georg22tech/CLInGER/Camera System/HRI/FD_images/amentum_visit_test/1.2/image_2025-03-18_11-54-18.jpg

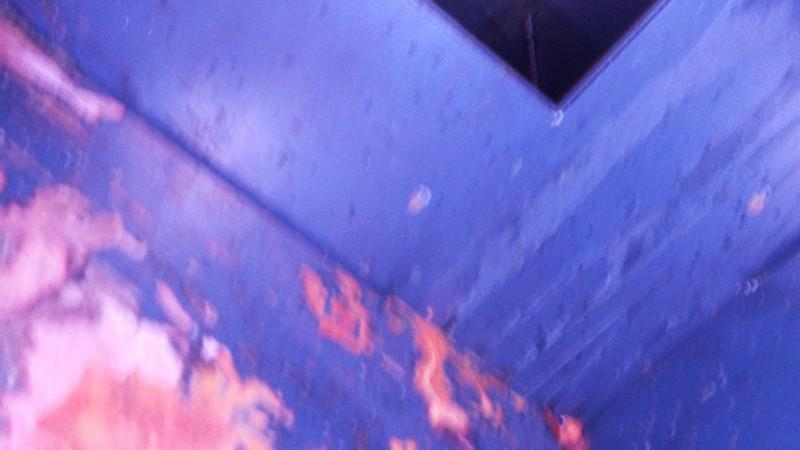
Camera System/HRI/FD_images/amentum_visit_test/1.2/image_2025-03-18_11-54-18.jpg
