georg22tech/CLInGER/README.md

# CLInGER
Repository of the Continuum Linear Inching Gantry Examination Robot (CLInGER)
