georg22tech/CLInGER/CAD_and_verification/Demo Day Schematics.pdf

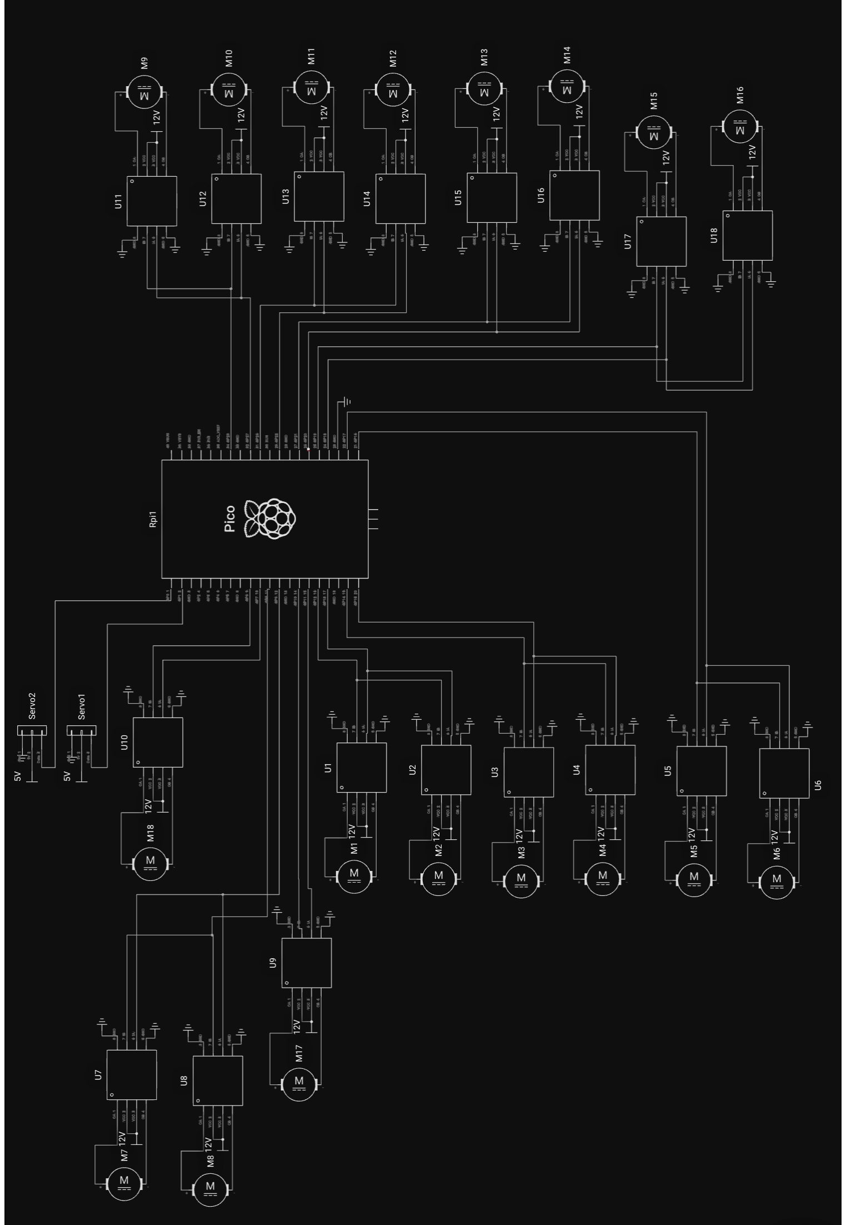
[picture p4: page 1]
