georg22tech/CLInGER/Appendices/Appendix A.15 - Control Methodology Diagrams/A.15.1 - continuum_ros2_interfaces.png

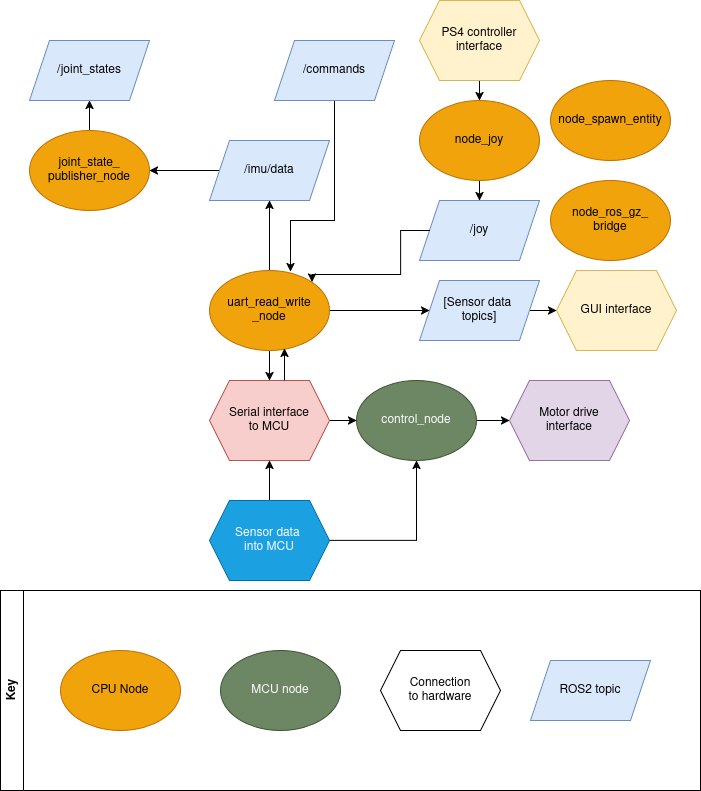
Appendices/Appendix A.15 - Control Methodology Diagrams/A.15.1 - continuum_ros2_interfaces.png
