georg22tech/CLInGER/Appendices/Appendix A.15 - Control Methodology Diagrams/A.15.2 - control_interactions_ros2.png

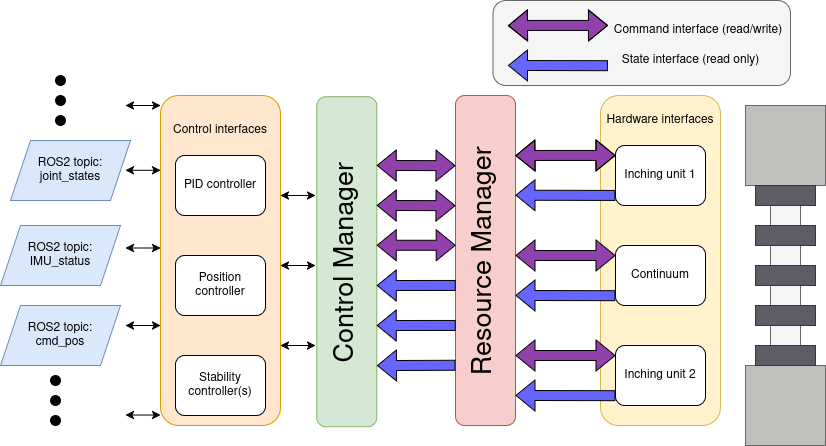
Appendices/Appendix A.15 - Control Methodology Diagrams/A.15.2 - control_interactions_ros2.png
