georg22tech/CLInGER/Appendices/Appendix A.15 - Control Methodology Diagrams/A.15.4 - continuum_control_flow.png

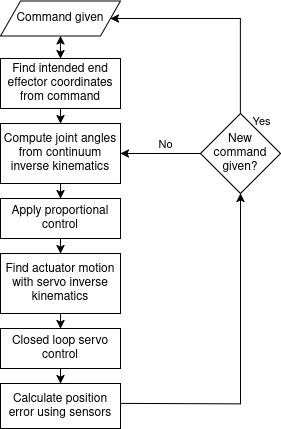
Appendices/Appendix A.15 - Control Methodology Diagrams/A.15.4 - continuum_control_flow.png
