georg22tech/CLInGER/Camera System/HRI/FD_images/image_2025-05-29_23-47-43.jpg

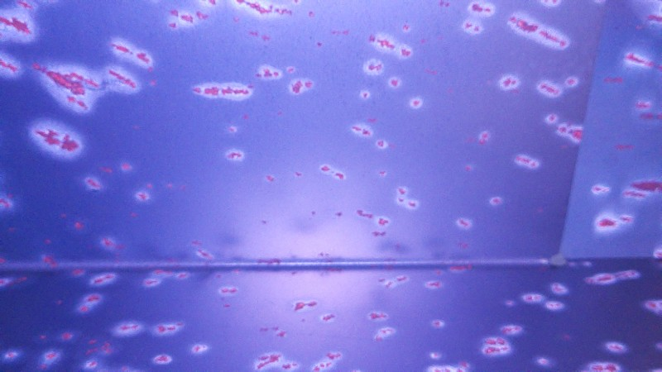
Camera System/HRI/FD_images/image_2025-05-29_23-47-43.jpg
