georg22tech/CLInGER/Camera System/HRI/FD_images/image_2025-05-30_00-00-45.jpg

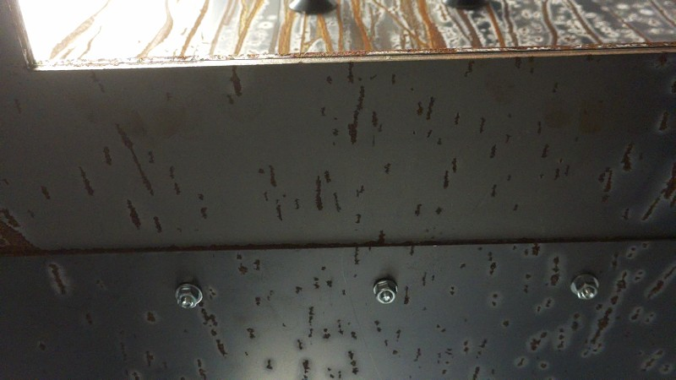
Camera System/HRI/FD_images/image_2025-05-30_00-00-45.jpg
