georg22tech/CLInGER/Camera System/HRI/FD_images/image_2025-05-30_00-04-07.jpg

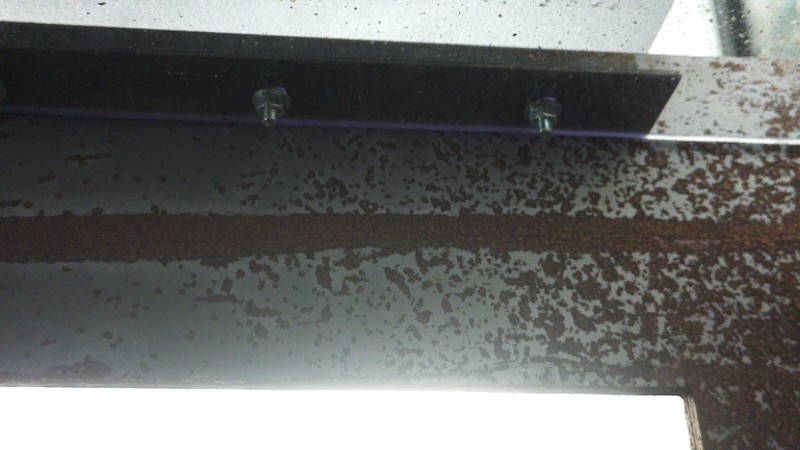
Camera System/HRI/FD_images/image_2025-05-30_00-04-07.jpg
