georg22tech/CLInGER/Camera System/HRI/yolo_v11_model/cracks_v4/train/confusion_matrix_normalized.png

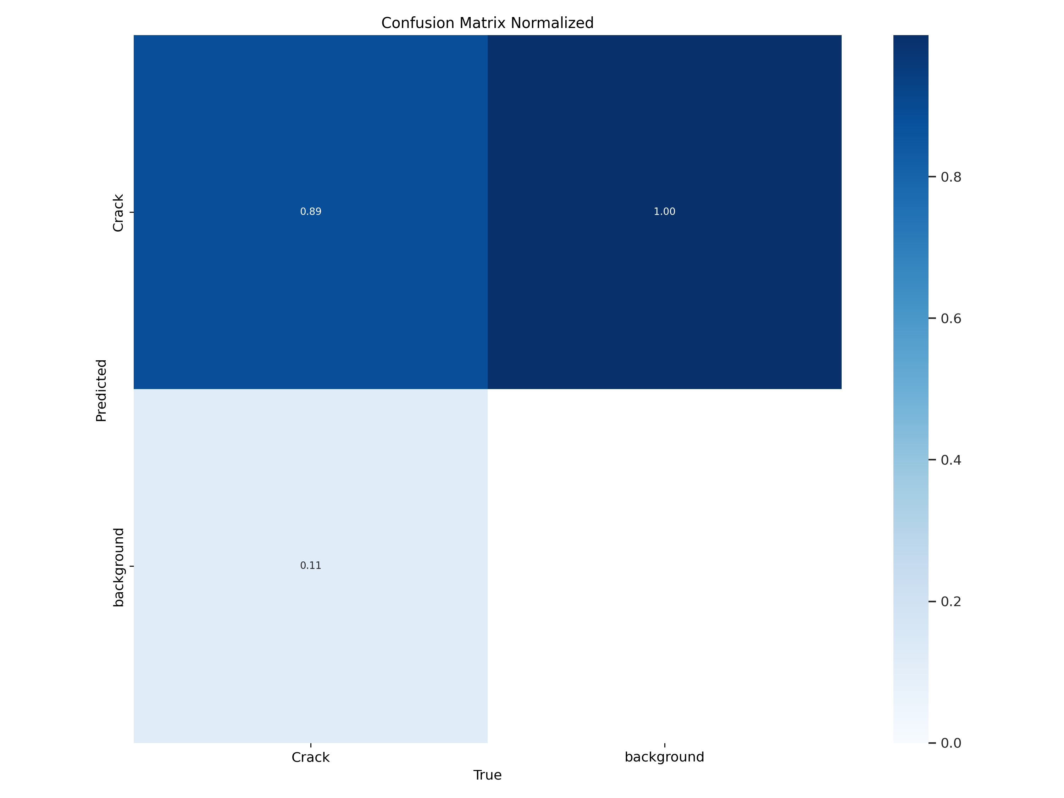
Camera System/HRI/yolo_v11_model/cracks_v4/train/confusion_matrix_normalized.png
