georg22tech/CLInGER/Camera System/HRI/yolo_v11_model/cracks_v4/train/labels_correlogram.jpg

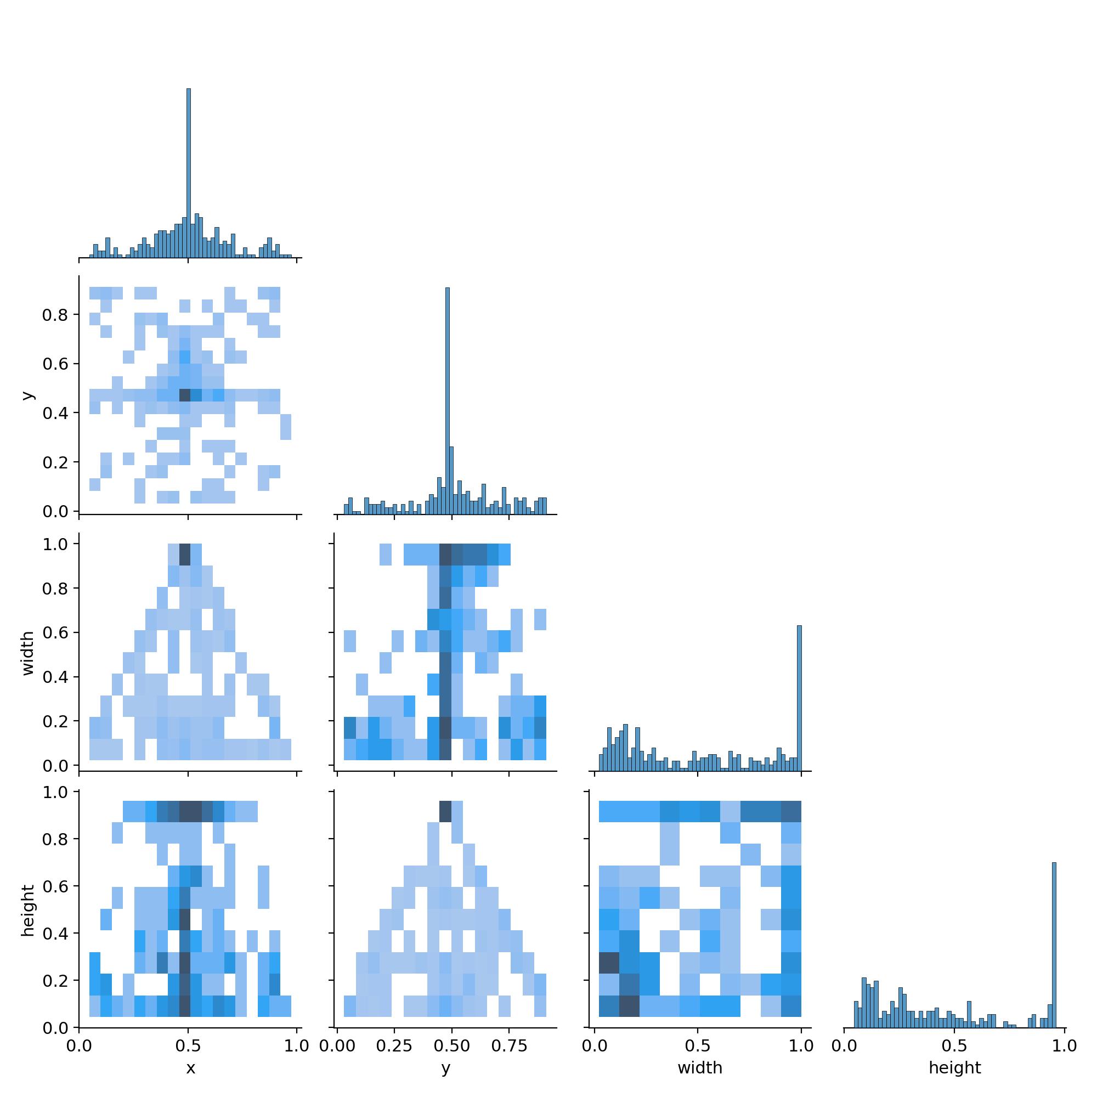
Camera System/HRI/yolo_v11_model/cracks_v4/train/labels_correlogram.jpg
