georg22tech/CLInGER/Camera System/HRI/yolo_v11_model/cracks_v4/train/R_curve.png

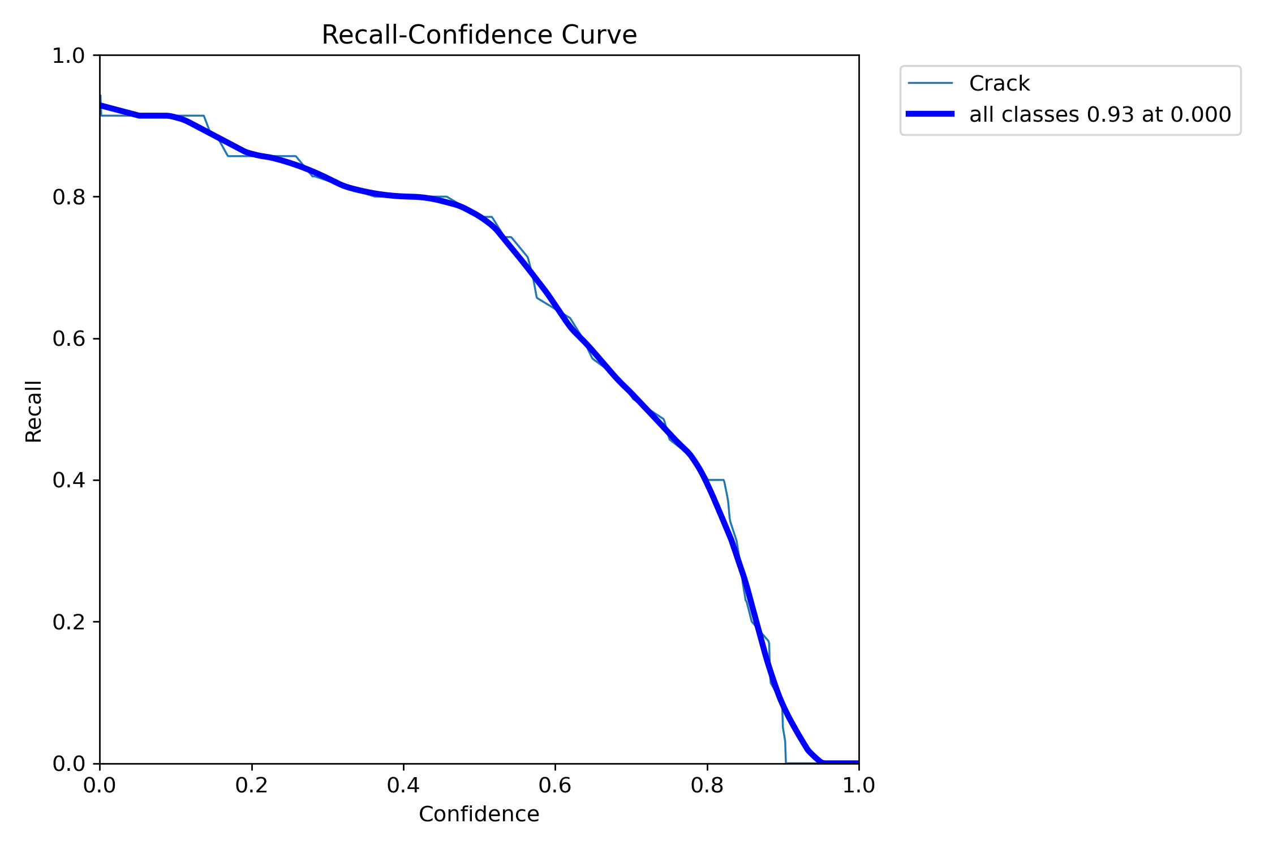
Camera System/HRI/yolo_v11_model/cracks_v4/train/R_curve.png
