georg22tech/CLInGER/Camera System/HRI/yolo_v11_model/cracks_v4/train/train_batch992.jpg

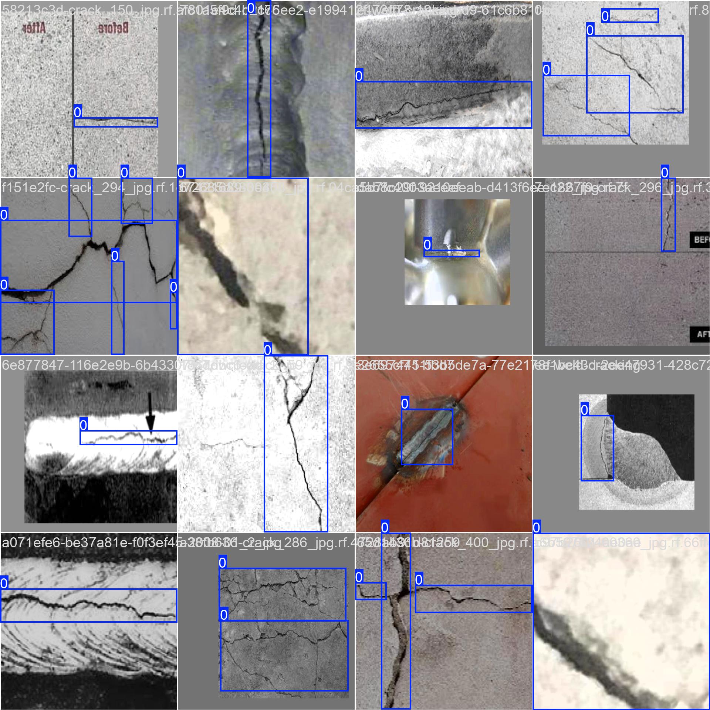
Camera System/HRI/yolo_v11_model/cracks_v4/train/train_batch992.jpg
