georg22tech/CLInGER/Camera System/HRI/yolo_v11_model/cracks_v4/train/val_batch0_labels.jpg

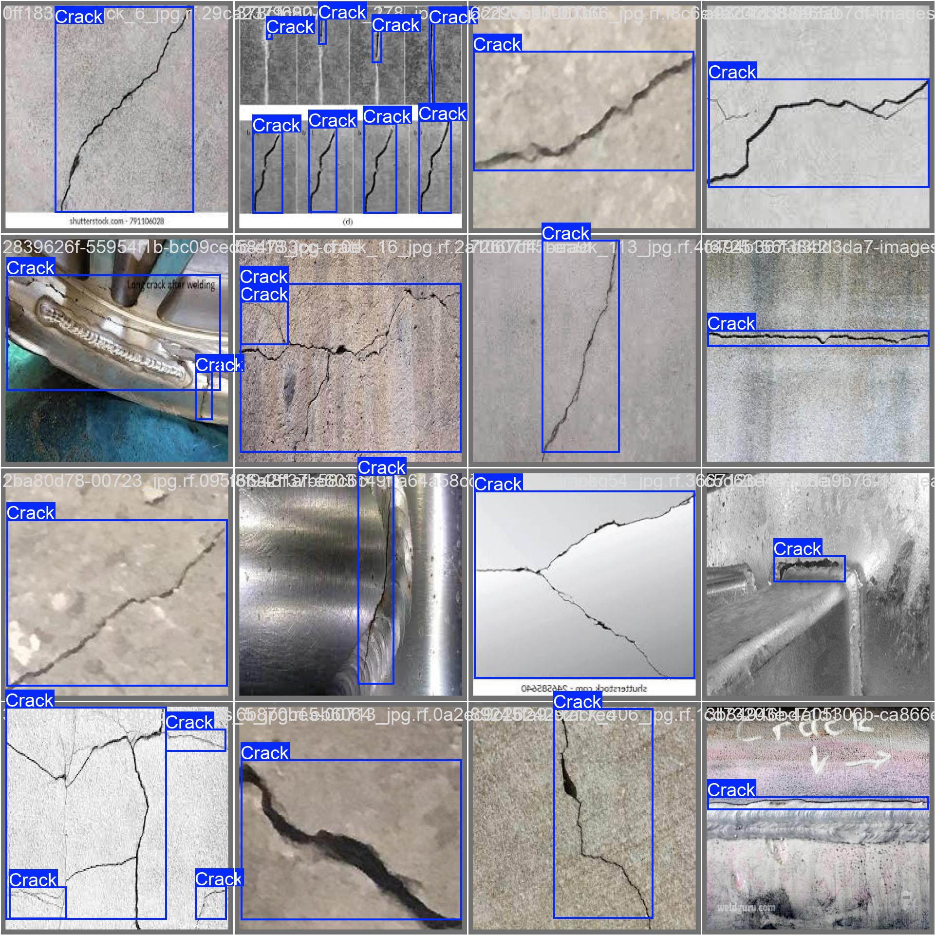
Camera System/HRI/yolo_v11_model/cracks_v4/train/val_batch0_labels.jpg
