georg22tech/CLInGER/Appendices/Appendix A.8 - Project Budget and Expenditure/Team 3 Inventory.xlsx

Sheet: Inventory Tracking
Number | Name | Category | Quantity | Location | Remarks
1 | Raspberry Pi 5 8GB | Control board | 1 | Main protoytpe
2 | Raspberry Pi Camera Module 3 | Sensor | 1 | Main protoytpe
3 | Raspberry Pi Pico | Control board | 4 | Main protoytpe | Preceding year item+ 3 bought this year, 2 on Main protoytpe
4 | RS Pro Timing Belt 6mm, 115.82mm | Inching mechanism | 1 | Room 2B.004
5 | Timing Belt Pulley 32 Tooth | Inching mechanism | 1 | Room 2B.004
6 | Timing Belt Pulley 12 Tooth | Inching mechanism | 1 | Room 2B.004
7 | Threaded Rod M10 1m | Inching mechanism | 1 | Room 2B.004
8 | M10 Hex Nut (50) | Inching mechanism | 1 | Room 2B.004
9 | Nylon 66 12mm width rods 1m | Turning mechanism | 1 | Room 2B.004 | Used for testing continuum backbone
10 | Nylon 66 5mm width rods 1m | Turning mechanism | 1 | Room 2B.004 | Used for testing continuum backbone
11 | Adafruit NeoPixel LED Ring | NDT payload | 1 | Main protoytpe
12 | TF Luna Lidar | Ranging sensor | 2 | Room 2B.004 | 1 used for demo prop
13 | Threadless Aluminium Alloy Busher | Turning mechanism | 100 | Room 2B.004 | 60 used for testing cycloid and continuum
14 | Micro Linear Actuator, 150 mm, 150 N | Holding mechanism | 17 | Main protoytpe | 16 on Main protoytpe
15 | Micro HDMI Cable, 5m | NDT payload | 1 | Room 2B.004
16 | Raspberry Pi 27W USB-C Power Supply | Pi 5 power supply | 1 | Room 2B.004
17 | RPi 5 Camera Adapter Cable, 500mm | NDT payload | 1 | Main protoytpe
18 | M6 Threaded Inserts, 9mm, pack of 20 | Inching mechanism | 1 | Room 2B.004
19 | M6 Threaded Rod, 1m | Inching mechanism | 3 | Room 2B.004
20 | GT2 9mm Timing Belt, 2.5m | Inching mechanism | 1 | Room 2B.004
21 | Grub Screws, M4x8mm, pack of 10 | Inching mechanism | 1 | Room 2B.004
22 | M6 Nut, pack of 50 | Inching mechanism | 1 | Room 2B.004
23 | M6 Lock Nut, pack of 50 | Inching mechanism | 1 | Room 2B.004
24 | GT2 Timing Belt Pulley, 20 teeth, 9mm belt, 8mm bore | Inching mechanism | 1 | Room 2B.004
25 | Bevel Gear, 5mm bore, 10 teeth | Inching mechanism | 1 | Room 2B.004
26 | 3M UV Safety glasses , PC Lens | Risk mitigating | 2 | Room 2B.004
27 | RS PRO M3 Brass Threaded Inserts, 4mm depth, 4.78mm (Pack of 100) | Turning mechanism | 1 | Room 2B.004
28 | Polycarbonate sheet 250x250x3mm | Inching mechanism | 5 | Room 2B.004 | Used for inching mechanism V1
29 | Polycarbonate sheet 100x500x3mm | Risk mitigating | 1 | Room 2B.004
30 | XL4015 DC-DC 5A Adjustable Step Down Power Supply Module | Power supply board | 5 | Main protoytpe
31 | L9110S H-Bridge Dual Channel Motor Driver | Actuator drive board | 12 | Main protoytpe | 6 on Main protoytpe
32 | 1.1A PTC Resettable Fuse 30V | Power supply safety | 8 | Room 2B.004
33 | 3-Way Single Row PCB Socket 2.54mm | PCB components | 16 | Main protoytpe
34 | 10-Way 3.81mm PCB Terminal 10A 150V | PCB components | 12 | Main protoytpe
35 | 40-Way Double Row PCB Socket 2.54mm | PCB components | 2 | Main protoytpe
36 | 20-Way Single Row PCB Socker 2.54mm | PCB components | 5 | Main protoytpe
37 | Spring Steel 2x40x1000x2 CS95 Carbon Steel | Turning mechanism | 2 | Main protoytpe | 1 piece on Main protoytpe
38 | RS PRO Bevel Gear, 5mm bore, 15 teeth, 1.0 module | Inching mechanism | 3 | Room 2B.004
39 | RS PRO Bevel Gear, 8mm bore, 30 teeth, 1.0 module | Inching mechanism | 1 | Room 2B.004
40 | Silicone Mold Making Kit 20A, Translucent, 38oz | Actuator end effector | 1 | Room 2B.004
41 | BNO055 9DOF Magnetic Field Module | Sensor | 3 | Main protoytpe | 2 on Main protoytpe
42 | VL53L1X Flight Time Sensors Module | Sensor | 6 | Main protoytpe | 4 on Main protoytpe
43 | 100m Fishing Line, 0.5mm Monofilament Clear Nylon Fishing Line | Turning mechanism | 1 | Room 2B.004
44 | Shift Register 8-bit - 74HC595 | Actuator control | 6 | Main protoytpe | 4 on Main protoytpe
45 | Wire-to board Terminal Block, Screwless, 5mm, 2-way | PCB components | 10 | Main protoytpe
46 | TruPower CQ-122N Mini Automotive Fuseholder | PCB components | 10 | Main protoytpe | 5 on Main protoytpe
47 | CamdenBoss 2 way, 10A, Interlocking Terminal Block, 3.81mm pitch | PCB components | 7 | Main protoytpe
48 | Sealey Automotive Standard Blade Fuse 5A | Power supply safety | 50 | Room 2B.004
49 | Sealey MBF550 Automotive MINI Blade Fuse 5A | Power supply safety | 50 | Room 2B.004 | 5 used for Main protoytpe
50 | ACS712 Hall Board Current Sensor Module 5A | Sensors | 8 | Room 2B.004
51 | 50kg Load Cell | Sensors | 4 | Room 2B.004
52 | HX711 Weight Pressure Sensor | Sensors | 2 | Room 2B.004
53 | Polycarbonate Clear 250x250x2mm | Chassis | 8 | Room 2B.004
54 | SER0046 Micro Servo | NDT payload | 2 | Main protoytpe
55 | Bourns 3690 10kOhm Rotary Potentiometer | Sensors | 2 | Room 2B.004
56 | Carbon Fibre Solid Rod 5x500 | Chassis | 4 | Main protoytpe
57 | CD74HC4067M96 Multiplexer Switch IC | Sensors | 10 | Main protoytpe | 2 used for Main protoytpe
58 | Micro Linear Actuator 12VDC, A Type 100mm, 150N 4mm/s | Actuator | 2 | Room 2B.004
59 | Small Linear Actuator, 12V 75mm stroke, Load 70N | Actuator | 2 | Main protoytpe
60 | Miniature Ball Bearing, 6x17x6mm | Chassis | 10 | Main protoytpe
61 | 40 kg Digital Servo High Voltage High Torque Metal Gear 360 Continuous Rotation | Turning mechanism | 3 | Main protoytpe | 2 used for Main protoytpe
62 | Polycarbonate Clear 1200x600x2mm | Chassis | 1 | Main protoytpe | Machined for chassis

Sheet: Handover Inventory
Number | Name | Category | Quantity | Location | Remarks
1 | Keysight E36312A Triple Output Programmable DC Power Supply | Tools | 1 | Room 2B.004
2 | 6000 Counts True RMS Multimeter | Tools | 1 | Room 2B.004
3 | WE70 Soldering Iron + WE1010 Power Unit | Tools | 1 | Room 2B.004
5 | 34450A 5 and 1/2 Digit Multimeter | Tools | 1 | Room 2B.004
6 | 33210A Function Generator | Tools | 1 | Room 2B.004
7 | RS Allen Key 1.5mm | Tools | 1 | Room 2B.004
8 | RS Allen Key 2mm | Tools | 1 | Room 2B.004
9 | RS Allen Key 2.5mm | Tools | 1 | Room 2B.004
10 | RS Allen Key 3mm | Tools | 1 | Room 2B.004
11 | RS Allen Key 4mm | Tools | 1 | Room 2B.004
12 | RS Allen Key 5mm | Tools | 1 | Room 2B.004
13 | RS Allen Key 6mm | Tools | 1 | Room 2B.004
14 | RS Allen Key 8mm | Tools | 1 | Room 2B.004
15 | RS Allen Key 10mm | Tools | 1 | Room 2B.004
16 | RS PRO Ignition Wrench 4mm | Tools | 1 | Room 2B.004
17 | RS PRO Ignition Wrench 4.5mm | Tools | 1 | Room 2B.004
18 | RS PRO Ignition Wrench 5mm | Tools | 1 | Room 2B.004
19 | RS PRO Ignition Wrench 5.5mm | Tools | 1 | Room 2B.004
20 | RS PRO Ignition Wrench 6mm | Tools | 1 | Room 2B.004
21 | RS PRO Ignition Wrench 7mm | Tools | 1 | Room 2B.004
22 | RS PRO Ignition Wrench 8mm | Tools | 1 | Room 2B.004
23 | RS PRO Ignition Wrench 9mm | Tools | 1 | Room 2B.004
24 | RS PRO Ignition Wrench 10mm | Tools | 1 | Room 2B.004
25 | RS PRO Ignition Wrench 11mm | Tools | 1 | Room 2B.004
26 | RS PRO Flathead Screwdriver 2x50 | Tools | 1 | Room 2B.004
27 | RS PRO Flathead Screwdriver 2.4x50 | Tools | 1 | Room 2B.004
28 | RS PRO Flathead Screwdriver 3x50 | Tools | 1 | Room 2B.004
29 | RS PRO Phillips Head Screwdriver 00x50 | Tools | 1 | Room 2B.004
30 | RS PRO Phillips Head Screwdriver 0x50 | Tools | 1 | Room 2B.004
31 | RS PRO Phillips Head Screwdriver 1x50 | Tools | 1 | Room 2B.004
32 | 606-490 Wire Cutter | Tools | 1 | Room 2B.004
33 | Tape Measure | Tools | 1 | Room 2B.004
34 | RS PRO Stanley Knife | Tools | 1 | Room 2B.004
35 | 0.5m Ethernet Cable | Others | 1 | Room 2B.004
36 | 0.5m HDMI to HMDI mini Cable | Others | 1 | Room 2B.004
37 | Raspberry Pi Camera 3 Wide Angle | Sensors | 1 | Room 2B.004
38 | Raspberry Pi Camera 2 8MP | Sensors | 2 | Room 2B.004
39 | Samsung 128GB Micro SD | Control | 1 | Room 2B.004 | Used on Pi 5
40 | TV6715DV 5.2V 2.5A USB-C Power Supply | Others | 1 | Room 2B.004
41 | USB-C Global Power Adapter 5.1V 15.3W | Others | 1 | Room 2B.004
42 | Bosch Sensortec Shuttle Board 3.0 BNO055 | Sensors | 1 | Room 2B.004
43 | VL53L5CX Breakout Boards | Sensors | 2 | Room 2B.004
44 | Raspberry Pi 5 8GB | Control board | 1 | Main protoytpe
45 | Raspberry Pi Camera Module 3 | Sensor | 1 | Main protoytpe
46 | Raspberry Pi Pico | Control board | 2 | Main protoytpe
47 | Threaded Rod M10 1m | Inching mechanism | 1 | Room 2B.004
48 | Adafruit NeoPixel LED Ring | NDT payload | 1 | Main protoytpe
49 | TF Luna Lidar | Ranging sensor | 2 | Room 2B.004 | 1 used for demo prop
50 | Micro Linear Actuator, 150 mm, 150 N | Holding mechanism | 17 | Main protoytpe | 16 on Main protoytpe
51 | Micro HDMI Cable, 5m | NDT payload | 1 | Room 2B.004
52 | Raspberry Pi 27W USB-C Power Supply | Pi 5 power supply | 1 | Room 2B.004
53 | RPi 5 Camera Adapter Cable, 500mm | NDT payload | 1 | Main protoytpe
54 | GT2 9mm Timing Belt, 2.5m | Inching mechanism | 1 | Room 2B.004
55 | Grub Screws, M4x8mm, pack of 10 | Inching mechanism | 1 | Room 2B.004
56 | Bevel Gear, 5mm bore, 10 teeth | Inching mechanism | 1 | Room 2B.004
57 | 3M UV Safety glasses , PC Lens | Risk mitigating | 2 | Room 2B.004
58 | L9110S H-Bridge Dual Channel Motor Driver | Actuator drive board | 12 | Main protoytpe | 6 on Main protoytpe
59 | 1.1A PTC Resettable Fuse 30V | Power supply safety | 8 | Room 2B.004
60 | Spring Steel 2x40x1000x2 CS95 Carbon Steel | Turning mechanism | 2 | Main protoytpe | 1 piece on Main protoytpe
61 | RS PRO Bevel Gear, 5mm bore, 15 teeth, 1.0 module | Inching mechanism | 3 | Room 2B.004
62 | RS PRO Bevel Gear, 8mm bore, 30 teeth, 1.0 module | Inching mechanism | 1 | Room 2B.004
63 | BNO055 9DOF Magnetic Field Module | Sensor | 3 | Main protoytpe | 2 on Main protoytpe
64 | VL53L1X Flight Time Sensors Module | Sensor | 6 | Main protoytpe | 4 on Main protoytpe
65 | 100m Fishing Line, 0.5mm Monofilament Clear Nylon Fishing Line | Turning mechanism | 1 | Room 2B.004
66 | Shift Register 8-bit - 74HC595 | Actuator control | 6 | Main protoytpe | 4 on Main protoytpe
67 | Sealey Automotive Standard Blade Fuse 5A | Power supply safety | 50 | Room 2B.004
68 | Sealey MBF550 Automotive MINI Blade Fuse 5A | Power supply safety | 50 | Room 2B.004 | 5 used for Main protoytpe
69 | ACS712 Hall Board Current Sensor Module 5A | Sensors | 8 | Room 2B.004
70 | SER0046 Micro Servo | NDT payload | 2 | Main protoytpe
71 | Bourns 3690 10kOhm Rotary Potentiometer | Sensors | 2 | Room 2B.004
72 | CD74HC4067M96 Multiplexer Switch IC | Sensors | 10 | Main protoytpe | 2 used for Main protoytpe
73 | Micro Linear Actuator 12VDC, A Type 100mm, 150N 4mm/s | Actuator | 2 | Room 2B.004
74 | Small Linear Actuator, 12V 75mm stroke, Load 70N | Actuator | 2 | Main protoytpe
75 | 40 kg Digital Servo High Voltage High Torque Metal Gear 360 Continuous Rotation | Turning mechanism | 2 | Main protoytpe | 2 used for Main protoytpe

Sheet: Main prototype
Item | Name | Quantity | Remarks
1 | Aluminium sheets | 8
2 | 3D printed spars | 44
3 | 3D printed feet | 16
4 | Carbon fibre rods 5mmx250mm | 8
5 | Custom PCB | 1 | Terminals and headers are not used because of motor drive board problem
6 | DC-DC buck converter | 5 | Soldered onto main PCB, 2 is broken but yet to debugged
7 | Motor drive board L9110S dual channel | 6
8 | Motor drive board L9110S four channel | 2
9 | Custom stripboard | 3 | Main stripboard containing Pico is not connected to power and yet to be debugged
10 | 3D printed ribs | 10
11 | 150N linear actuator 150mm extension | 16
12 | 150N linear actuator 75mm extension | 2
13 | 40kg digital servo continuous rotation | 2
14 | 24V/300W switching power supply | 1

Sheet: Demo Prop
Item | Name | Quantity | Remarks
1 | Custom 3D printed prop | 1
2 | Custom stripboard | 1
3 | ToF VL53l1X | 3
4 | TF Luna Lidar | 1
5 | BNO055 IMU Sensor | 2
6 | I2C Multiplexer TCA9548A | 1
7 | Trimmer Potentiometer 100kOhm | 1

Sheet: Camera prototype
Item | Name | Quantity | Remarks
 | 3D printed Camera mechanism | 1
 | Raspnberry Pi Camera Module 3 | 1
 | LED Ring | 1
 | 270 degrees DMS-MG90-A Micro Servo | 2
 | Custom stripboard | 1
 | Custom PCB | 1
 | Raspberry Pi Pico H | 1
