georg22tech/CLInGER/Appendices/Appendix A.8 - Project Budget and Expenditure/Order Forms/241108_MEng Team 3 Project Order Form 1.xlsx

Department of Electrical & Electronic Engineering MEng Team Project - Order Request
Team number & name | MEng Team 3 | Authorising Supervisor's Signature |  |  |  |  |  | Please use publicly quoted prices below,
Auditor name | Muhammad Bin Suratman |  |  |  |  |  |  | but note that University pricing may be different
Team AA code | AA18001
Supervisor names | Dr Simon Watson, Dr Paul Wright
Order request date | 2024-11-08 |  |  |  |  |  |  | Please be sure to quote prices excluding VAT
Company | Item Description | URL from Supplier Website | Reason for purchase | Implications if the order is not placed | Quantity | Item cost | Total cost | Office use
Farnell | Raspberry Pi 5 8GB | https://uk.farnell.com/raspberry-pi/rpi5-8gb-single/raspberry-pi-5-model-b-8gb-2-4ghz/dp/4256000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 | Control board for robot | Necessary to control sensors and actuators | 1 | £61.07 | £61.07
Farnell | Raspberry Pi Camera Module 3 | https://uk.farnell.com/raspberry-pi/sc0872/rpi-camera-mod-3-standard-lens/dp/4132318 | Sensor for robot | Robot cannot navigate | 1 | £19.23 | £19.23
RS | RS Pro Timing Belt 6mm, 115.82mm | https://uk.rs-online.com/web/p/timing-belts/7785039 | Testing load capability of motor | Motor cannot be tested | 1 | £1.62 | £1.62
RS | Timing Belt Pulley 32 Tooth | https://uk.rs-online.com/web/p/belt-pulleys/2362817?gb=s | Testing load capability of motor | Motor cannot be tested | 1 | £5.10 | £5.10
RS | Timing Belt Pulley 12 Tooth | https://uk.rs-online.com/web/p/belt-pulleys/2362767?gb=s | Testing load capability of motor | Motor cannot be tested | 1 | £3.40 | £3.40
Farnell | Threaded Rod M10 1m | https://uk.farnell.com/duratool/rod10/studding-steel-m10/dp/2444308 | Testing load capability of motor | Motor cannot be tested | 1 | £4.15 | £4.15
Farnell | M10 Hex Nut (pack of 50) | https://uk.farnell.com/tr-fastenings/m10-hfst-z50/full-nut-steel-bzp-m10-pk50/dp/1419453 | Testing load capability of motor | Motor cannot be tested | 1 | £5.66 | £5.66
 |  |  |  |  |  |  | £0.00
 |  |  |  |  |  |  | £0.00
 |  |  |  |  |  |  | £0.00
 |  |  |  |  |  |  | £0.00
 |  |  |  |  |  |  | £0.00
 |  |  |  |  |  |  | £0.00
 |  |  |  |  |  |  | £0.00
 |  |  |  |  |  |  | £0.00
 |  |  |  |  |  |  | £0.00
 |  |  |  |  |  |  | £0.00
 |  |  |  |  |  |  | £0.00
 |  |  |  |  |  |  | £0.00
 |  |  |  |  |  |  | £0.00
 |  |  |  |  |  |  | £0.00
 |  |  |  |  |  |  | £0.00
 |  |  |  |  |  |  | £0.00
 |  |  |  |  |  | ORDER TOTAL EXCL VAT | £100.23
Office use only |  |  |  |  |  | VAT | £20.05
Ordered by |  |  |  |  |  | ORDER TOTAL INCL VAT | £120.28
Order date
Requisition number
Note: All orders must be marked as follows, to ensure appropriate receipt of the items
4th year Project Team Number and Auditor’s Name, FAO - Daniel Vale, Room D8, Sackville Street Building – Delivery to Mr Peter Thomason, GRD stores, The Mill, Sackville St, University of Manchester, Manchester. M1 3BB.
