georg22tech/CLInGER/Appendices/Appendix A.8 - Project Budget and Expenditure/Order Forms/250131_MEng Team 3 Project Order Form 3.xlsx

Department of Electrical & Electronic Engineering MEng Team Project - Order Request
Team number & name | MEng Team 3 | Authorising Supervisor's Signature |  |  |  |  |  | Please use publicly quoted prices below,
Auditor name | Muhammad Bin Suratman |  |  |  |  |  |  | but note that University pricing may be different
Team AA code | AA18001
Supervisor names | Dr Simon Watson, Dr Paul Wright
Order request date | 2025-01-31 |  |  |  |  |  |  | Please be sure to quote prices excluding VAT
Company | Item Description | URL from Supplier Website | Reason for purchase | Implications if the order is not placed | Quantity | Item cost | Total cost | Office use
RS | Bevel Gear, 5mm Bore, 10 teeth | https://uk.rs-online.com/web/p/mitre-bevel-gears/1828012?gb=s | To build the necessary chassis for project | Chassis cannot be build | 1 | £5.31 | £5.31
 |  |  |  |  |  |  | £0.00
 |  |  |  |  |  |  | £0.00
 |  |  |  |  |  |  | £0.00
 |  |  |  |  |  |  | £0.00
 |  |  |  |  |  |  | £0.00
 |  |  |  |  |  |  | £0.00
 |  |  |  |  |  |  | £0.00
 |  |  |  |  |  |  | £0.00
 |  |  |  |  |  |  | £0.00
 |  |  |  |  |  |  | £0.00
 |  |  |  |  |  |  | £0.00
 |  |  |  |  |  |  | £0.00
 |  |  |  |  |  |  | £0.00
 |  |  |  |  |  |  | £0.00
 |  |  |  |  |  |  | £0.00
 |  |  |  |  |  |  | £0.00
 |  |  |  |  |  |  | £0.00
 |  |  |  |  |  |  | £0.00
 |  |  |  |  |  |  | £0.00
 |  |  |  |  |  |  | £0.00
 |  |  |  |  |  |  | £0.00
 |  |  |  |  |  |  | £0.00
 |  |  |  |  |  | ORDER TOTAL EXCL VAT | £5.31
Office use only |  |  |  |  |  | VAT | £1.06
Ordered by |  |  |  |  |  | ORDER TOTAL INCL VAT | £6.37
Order date
Requisition number
Note: All orders must be marked as follows, to ensure appropriate receipt of the items
4th year Project Team Number and Auditor’s Name, FAO - Daniel Vale, Room D8, Sackville Street Building – Delivery to Mr Peter Thomason, GRD stores, The Mill, Sackville St, University of Manchester, Manchester. M1 3BB.
