georg22tech/CLInGER/Appendices/Appendix A.8 - Project Budget and Expenditure/Order Forms/250211_MEng Team 3 Project Order Form 4.xlsx

Department of Electrical & Electronic Engineering MEng Team Project - Order Request
Team number & name | MEng Team 3 | Authorising Supervisor's Signature |  |  |  |  |  | Please use publicly quoted prices below,
Auditor name | Muhammad Bin Suratman |  |  |  |  |  |  | but note that University pricing may be different
Team AA code | AA18001
Supervisor names | Dr Simon Watson, Dr Paul Wright
Order request date | 2025-02-11 |  |  |  |  |  |  | Please be sure to quote prices excluding VAT
Company | Item Description | URL from Supplier Website | Reason for purchase | Implications if the order is not placed | Quantity | Item cost | Total cost | Office use
RS | 3M UV Safety Glasses, PC Lens | https://uk.rs-online.com/web/p/safety-glasses/1849475?gb=s | EN166 Safety requirements | Students may be at harm | 2 | £2.16 | £4.32
RS | Portwest Grey Polyurethane Cut Resistant Gloves, Size 9, 1 Pair | https://uk.rs-online.com/web/p/work-gloves/2372807?gb=s | EN388 Safety requirements | Students may be at harm | 2 | £4.00 | £8.00
RS | RS PRO M3 Brass Threaded Insert 4mm depth 4.78 mm (pack of 100) | https://uk.rs-online.com/web/p/threaded-inserts/0278584?gb=s | For building the robot | Robot might not work properly | 1 | £16.67 | £16.67
DirectPlastics | Polycarbonate clear 250x250x3mm | https://www.directplastics.co.uk/lexan-polycarb-sheet-250-x-250-x-3mm | For testing the robot chassis | Robot might not work properly | 3 | £3.30 | £9.90
DirectPlastics | Polycarbonate clear 1000x500x3mm | https://www.directplastics.co.uk/lexan-polycarb-sheet-1000-x-500-x-3mm | For testing spring steel | Students may be at harm | 1 | £21.78 | £21.78
 |  |  |  |  |  |  | £0.00
 |  |  |  |  |  |  | £0.00
 |  |  |  |  |  |  | £0.00
 |  |  |  |  |  |  | £0.00
 |  |  |  |  |  |  | £0.00
 |  |  |  |  |  |  | £0.00
 |  |  |  |  |  |  | £0.00
 |  |  |  |  |  |  | £0.00
 |  |  |  |  |  |  | £0.00
 |  |  |  |  |  |  | £0.00
 |  |  |  |  |  |  | £0.00
 |  |  |  |  |  |  | £0.00
 |  |  |  |  |  |  | £0.00
 |  |  |  |  |  |  | £0.00
 |  |  |  |  |  |  | £0.00
 |  |  |  |  |  |  | £0.00
 |  |  |  |  |  |  | £0.00
 |  |  |  |  |  |  | £0.00
 |  |  |  |  |  | ORDER TOTAL EXCL VAT | £60.67
Office use only |  |  |  |  |  | VAT | £12.13
Ordered by |  |  |  |  |  | ORDER TOTAL INCL VAT | £72.80
Order date
Requisition number
Note: All orders must be marked as follows, to ensure appropriate receipt of the items
4th year Project Team Number and Auditor’s Name, FAO - Daniel Vale, Room D8, Sackville Street Building – Delivery to Mr Peter Thomason, GRD stores, The Mill, Sackville St, University of Manchester, Manchester. M1 3BB.
