georg22tech/CLInGER/Appendices/Appendix A.8 - Project Budget and Expenditure/Order Forms/250221_MEng Team 3 Project Order Form 5.xlsx

Department of Electrical & Electronic Engineering MEng Team Project - Order Request
Team number & name | MEng Team 3 | Authorising Supervisor's Signature |  |  |  |  |  | Please use publicly quoted prices below,
Auditor name | Muhammad Bin Suratman |  |  |  |  |  |  | but note that University pricing may be different
Team AA code | AA18001
Supervisor names | Dr Simon Watson, Dr Paul Wright
Order request date | 2025-02-21 |  |  |  |  |  |  | Please be sure to quote prices excluding VAT
Company | Item Description | URL from Supplier Website | Reason for purchase | Implications if the order is not placed | Quantity | Item cost | Total cost | Office use
RS | RS PRO Bevel Gear, 5mm bore, 15 teeth, 1.0 module (pack of 3) | https://uk.rs-online.com/web/p/mitre-bevel-gears/1828002?gb=s | To build the necessary chassis for project | Chassis cannot be build | 1 | £6.36 | £6.36
RS | RS PRO Bevel Gear, 8mm bore, 30 teeth, 1.0 module | https://uk.rs-online.com/web/p/mitre-bevel-gears/1827994?gb=s | To build necessary chassis for project | Chassis cannot be build | 1 | £5.81 | £5.81
Rapid | Raspberry Pi 2MB SC0917 Pico H 32-bit | https://www.rapidonline.com/raspberry-pi-2mb-sc0917-pico-h-32-bit-soc-singles-75-1230 | Control board for the robot | Robot cannot be controlled | 1 | £4.04 | £4.04
Mouser | TF Luna Lidar | https://www.mouser.co.uk/ProductDetail/Benewake/TF-Luna-I2C?qs=DPoM0jnrROUWvdDwJYVpzw%3D%3D | Sensor for the robot | Data cannot be acquired | 1 | £16.42 | £16.42
 |  |  |  |  |  |  | £0.00
 |  |  |  |  |  |  | £0.00
 |  |  |  |  |  |  | £0.00
 |  |  |  |  |  |  | £0.00
 |  |  |  |  |  |  | £0.00
 |  |  |  |  |  |  | £0.00
 |  |  |  |  |  |  | £0.00
 |  |  |  |  |  |  | £0.00
 |  |  |  |  |  |  | £0.00
 |  |  |  |  |  |  | £0.00
 |  |  |  |  |  |  | £0.00
 |  |  |  |  |  |  | £0.00
 |  |  |  |  |  |  | £0.00
 |  |  |  |  |  |  | £0.00
 |  |  |  |  |  |  | £0.00
 |  |  |  |  |  |  | £0.00
 |  |  |  |  |  |  | £0.00
 |  |  |  |  |  |  | £0.00
 |  |  |  |  |  |  | £0.00
 |  |  |  |  |  | ORDER TOTAL EXCL VAT | £32.63
Office use only |  |  |  |  |  | VAT | £6.53
Ordered by |  |  |  |  |  | ORDER TOTAL INCL VAT | £39.16
Order date
Requisition number
Note: All orders must be marked as follows, to ensure appropriate receipt of the items
4th year Project Team Number and Auditor’s Name, FAO - Daniel Vale, Room D8, Sackville Street Building – Delivery to Mr Peter Thomason, GRD stores, The Mill, Sackville St, University of Manchester, Manchester. M1 3BB.
