georg22tech/CLInGER/Appendices/Appendix A.8 - Project Budget and Expenditure/Order Forms/250304_MEng Team 3 Project Order Form 6.xlsx

Department of Electrical & Electronic Engineering MEng Team Project - Order Request
Team number & name | MEng Team 3 | Authorising Supervisor's Signature |  |  |  |  |  | Please use publicly quoted prices below,
Auditor name | Muhammad Bin Suratman |  |  |  |  |  |  | but note that University pricing may be different
Team AA code | AA18001
Supervisor names | Dr Simon Watson, Dr Paul Wright
Order request date | 2025-03-04 |  |  |  |  |  |  | Please be sure to quote prices excluding VAT
Company | Item Description | URL from Supplier Website | Reason for purchase | Implications if the order is not placed | Quantity | Item cost | Total cost | Office use
Farnell | Wire-to board Terminal Block, Screwless, 5mm, 2 ways, 28 AWG(minimum 10) | https://uk.farnell.com/te-connectivity/2834076-1/tb-wire-to-board-2pos-28-14awg/dp/2610397 | Power distribution for project | Robot cannot be powered | 10 | £0.55 | £5.45
Rapid | TruPower CQ-122N Mini Automotive Fuseholder | https://www.rapidonline.com/trupower-cq-122n-mini-automotive-fuseholder-26-2470 | Fuse holder for power protection | Risk of fire if short circuit happen | 10 | £0.46 | £4.59
Rapid | CamdenBoss 2 way, 10A, Interlocking Terminal Block, 3.81mm pitch | https://www.rapidonline.com/camdenboss-ctb0308-2-2-way-10a-interlocking-terminal-block-3-81mm-pitch-21-1655 | Power distribution for project | Robot cannot be powered | 7 | £1.35 | £9.45
Rapid | Sealey Automotive Standard Blade Fuse 5A (pack of 50) | https://www.rapidonline.com/sealey-sbf550-automotive-standard-blade-fuse-5a-pack-of-50-84-0518 | Fuse for power protection | Risk of fire if short circuit happen | 1 | £1.99 | £1.99
 |  |  |  |  |  |  | £0.00
 |  |  |  |  |  |  | £0.00
 |  |  |  |  |  |  | £0.00
 |  |  |  |  |  |  | £0.00
 |  |  |  |  |  |  | £0.00
 |  |  |  |  |  |  | £0.00
 |  |  |  |  |  |  | £0.00
 |  |  |  |  |  |  | £0.00
 |  |  |  |  |  |  | £0.00
 |  |  |  |  |  |  | £0.00
 |  |  |  |  |  |  | £0.00
 |  |  |  |  |  |  | £0.00
 |  |  |  |  |  |  | £0.00
 |  |  |  |  |  |  | £0.00
 |  |  |  |  |  |  | £0.00
 |  |  |  |  |  |  | £0.00
 |  |  |  |  |  |  | £0.00
 |  |  |  |  |  |  | £0.00
 |  |  |  |  |  |  | £0.00
 |  |  |  |  |  | ORDER TOTAL EXCL VAT | £21.48
Office use only |  |  |  |  |  | VAT | £4.30
Ordered by |  |  |  |  |  | ORDER TOTAL INCL VAT | £25.78
Order date
Requisition number
Note: All orders must be marked as follows, to ensure appropriate receipt of the items
4th year Project Team Number and Auditor’s Name, FAO - Daniel Vale, Room D8, Sackville Street Building – Delivery to Mr Peter Thomason, GRD stores, The Mill, Sackville St, University of Manchester, Manchester. M1 3BB.
