georg22tech/CLInGER/Appendices/Appendix A.8 - Project Budget and Expenditure/Order Forms/250328_MEng Team 3 Project Order Form 10.xlsx

Department of Electrical & Electronic Engineering MEng Team Project - Order Request
Team number & name | MEng Team 3 | Authorising Supervisor's Signature |  |  |  |  |  | Please use publicly quoted prices below,
Auditor name | Muhammad Bin Suratman |  |  |  |  |  |  | but note that University pricing may be different
Team AA code | AA18001
Supervisor names | Dr Simon Watson, Dr Paul Wright
Order request date | 2025-03-28 |  |  |  |  |  |  | Please be sure to quote prices excluding VAT
Company | Item Description | URL from Supplier Website | Reason for purchase | Implications if the order is not placed | Quantity | Item cost | Total cost | Office use
Farnell | SER0046 Micro Servo | https://uk.farnell.com/dfrobot/ser0046/servo-motor-270deg-1-47n-m-6v/dp/3769942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 | Camera control | Camera cannot be controlled | 2 | £5.95 | £11.90
Farnell | Raspberry Pi Pico H | https://uk.farnell.com/raspberry-pi/raspberry-pi-pico-h/raspberry-pi-board-arm-cortex/dp/3996081 | Sensors and actuator control | Cannot read sensors and control actuators | 2 | £3.97 | £7.94
RS | Bourns 3690 10kOhm Rotary Potentiometer | https://uk.rs-online.com/web/p/potentiometers/1070785?gb=s | Encoder testing | Encoder cannot be tested | 2 | £13.44 | £26.88
Mouser | Adafruit 9-DoF Absolute Orientation IMU BNO055 | https://www.mouser.co.uk/ProductDetail/Adafruit/4646?qs=W%2FMpXkg%252BdQ4Msqspav40iw%3D%3D | To build robot | Robot cannot be built | 1 | £19.68 | £19.68
Mouser | Distance Sensor VL53L1X ToF Sensor Breakout | https://www.mouser.co.uk/ProductDetail/Pimoroni/PIM373?qs=lc2O%252BfHJPVbu7kI%2FlA0xSg%3D%3D | To build robot | Robot cannot be built | 2 | £12.55 | £25.10
 |  |  |  |  |  |  | £0.00
 |  |  |  |  |  |  | £0.00
 |  |  |  |  |  |  | £0.00
 |  |  |  |  |  |  | £0.00
 |  |  |  |  |  |  | £0.00
 |  |  |  |  |  |  | £0.00
 |  |  |  |  |  |  | £0.00
 |  |  |  |  |  |  | £0.00
 |  |  |  |  |  |  | £0.00
 |  |  |  |  |  |  | £0.00
 |  |  |  |  |  |  | £0.00
 |  |  |  |  |  |  | £0.00
 |  |  |  |  |  |  | £0.00
 |  |  |  |  |  |  | £0.00
 |  |  |  |  |  |  | £0.00
 |  |  |  |  |  |  | £0.00
 |  |  |  |  |  |  | £0.00
 |  |  |  |  |  |  | £0.00
 |  |  |  |  |  | ORDER TOTAL EXCL VAT | £91.50
Office use only |  |  |  |  |  | VAT | £18.30
Ordered by |  |  |  |  |  | ORDER TOTAL INCL VAT | £109.80
Order date
Requisition number
Note: All orders must be marked as follows, to ensure appropriate receipt of the items
4th year Project Team Number and Auditor’s Name, FAO - Daniel Vale, Room D8, Sackville Street Building – Delivery to Mr Peter Thomason, GRD stores, The Mill, Sackville St, University of Manchester, Manchester. M1 3BB.
