georg22tech/CLInGER/Appendices/Appendix A.2 - Risk Registers/Appendix - Mitigating Risks.xlsx

ID | Risk Description | Category | Likelihood | Impact | Risk Score | Mitigation Strategy | Owner | Notes on Decisions
1 | Camera fails to reach rear flange due to 180° servo design mechanical limits | Technical | 4 | 4 | 16 | Switched from 180° to 270° micro-servos; tested in lab mock-up to confirm coverage | Alen | Original 180° design dropped; new design proved complete coverage
2 | Glare/reflection from LED ring obscures crack detection | Technical | 3 | 4 | 12 | Set default LED brightness to 25%; allow runtime adjustment; consider diffuser in future | Alen | High brightness (>50%) caused glare; 25% balanced exposure.
3 | Autofocus on Pi Camera unreliable under movement, blurring images | Technical | 2 | 3 | 6 | Added manual focus slider so operator can adjust focus in real time | Alen | Disabled Pi Cam’s autofocus; manual focus gives consistent sharpness despite camera motion.
4 | Image‐capture failure or metadata loss | Technical | 1 | 3 | 3 | Implementing a error popup | Alen | Future work can include this feature, due to time constraint not available in final demonstration
5 | UART comms drop-outs between Pi 5 and Pico causing misalignment | Technical | 2 | 4 | 8 | Adding robust PCB headers, enruing that connection cannot be lost | Mur | Headers have been included
6 | Dataset bias or poor generalization of crack-detection model | Technical | 2 | 5 | 10 | Trained on diverse materials from Roboflow; plan to augment with on-site images before final deploy | Alen | Current dataset covers common cases; further fine-tuning needed for rare defect types.
7 | Latency in camera feed due to object deteciton overlay | Technical | 4 | 1 | 4 | Creating YOLO toggle on GUI disabling overlay to increase FPS; consider multi-threaded display loop | Alen | Toggling off YOLO overlay measurably increased feed FPS
8 | Continuum backbone permanent deformation due to material fatigue | Technical | 3 | 4 | 12 | Switched from nylon 66 to 2 mm spring steel sheet | Madeline | Initial nylon tests showed permanent set; spring steel backbone shows retention
9 | Anchor ribs 3D-printed material cracking at continuum-inching interface | Technical | 2 | 4 | 8 | Recommend future work to have CNC-machined metal ribs for production | George | Budget constraints dictated 3D-print; but metal will improve durability under repeated loads
10 | Ergonomic confusion in PS4-controller mapping | Usability | 2 | 3 | 6 | Adding a control map tab to the GUI so the operator can review commands throughout the inspection | Alen | Future work can include this feature, due to time constraint not available in final demonstration
11 | Sensor-fusion drift or misalignment in RViz visualization | Technical | 2 | 4 | 8 | Adopted direct sensor data publisher (no Kalman) given low robot speeds | Danny
12 | Continuum-inching cable fatigue and snagging | Operational | 2 | 3 | 6 | Routed cables along non-tendon side,used abrasion-resistant sleevin | Madeline
13 | Inching mechanism stalls under load due to belt/rod friction | Operational | 3 | 4 | 12 | Lubricate guide rods and timing belts; include stall-detection in firmware to retry or reverse if jammed | Mur | Lubrication will be added on demonstration day
14 | Sensor sampling jitter impacting localization accuracy | Sensing | 2 | 3 | 6 | Improve multi-threading code | Danny
15 | Raspberry Pi 5 CPU thermal throttling under sustained high load | Hardware | 2 | 4 | 8 | Add heatsink + small fan; monitor CPU temperature in firmware and throttle non-critical tasks; alert operator if throttling occurs | Alen | Currently whilst operating temperature do not exceed safety values, however, for future work this can be implemented so hardware does not overheat during oepration
16 |  |  |  |  | 0
17 |  |  |  |  | 0
18 |  |  |  |  | 0
19 |  |  |  |  | 0
20 |  |  |  |  | 0
