georg22tech/CLInGER/Appendices/Appendix A.8 - Project Budget and Expenditure/Team 3 Budget.xlsx

Sheet: Preferred Supplier List
Lot | Description | Appointed Suppliers | Contact Name | Email Address | Telephone Number
1 | Electronic Components Associated Products & Service Kits | 1. City Electrical Factors | Paul Nightingale | 32TUnato@cef.co.ukU32T | 01733 402816
 |  | 2. Farnell Onecall | Michael Reeks | 32Tmreeks@premierfarnell.com32T | 07920 419 500
 |  | 3. Rapid Electronics | Chris Calver | 32Tchris.calver@rapidonline.com32T | 01206 838020
 |  | 4. Rexel | Tom Norris | 32Ttom.Norris@rexel.co.uk32T | 07741 291484
 |  | 5. RS Components | Kudzai Manduvi | 32TKudzai.manduvi@rs-components.com32T | 07827 841519
2 | Tools & Fixings | 1. City Electrical Factors | Paul Nightingale | 32Tnato@cef.co.uk32T | 01733 402816
 |  | 2. Farnell Onecall | Michael Reeks | 32Tmreeks@premierfarnell.com32T | 07920 419 500
 |  | 3. Rapid Electronics | Chris Calver | 32Tchris.calver@rapidonline.com32T | 01206 838020
 |  | 4. Rexel | Tom Norris | 32Ttom.Norris@rexel.co.uk32T | 07741 291484
 |  | 5. RS Components | Kudzai Manduvi | 32TKudzai.manduvi@rs-components.com32T | 07827 841519
 |  | 6. Screwfix Direct | Zoe Harris | 32TZoe.harris@screwfix.com32T | 01935 441767
 |  | 7. YESSS Ltd | Giles Parker | 32Tnationalaccounts@yesss.co.uk32T | 07854 366814
3 | Test & Measurement Equipment | 1. City Electrical Factors | Paul Nightingale | 32Tnato@cef.co.uk32T | 01733 402816
 |  | 2. Farnell Onecall | Michael Reeks | 32Tmreeks@premierfarnell.com32T | 07920 419 500
 |  | 3. Rapid Electronics | Chris Calver | 32Tchris.calver@rapidonline.com32T | 01206 838020
 |  | 4. Rexel | Tom Norris | 32Ttom.Norris@rexel.co.uk32T | 07741 291484
 |  | 5. RS Components | Kudzai Manduvi | 32TKudzai.manduvi@rs-components.com32T | 07827 841519
 |  | 6. Lambda Photometrics | Peter Davenport | 32TPeter.davenport@lambdaphoto.co.uk32T | 07792 200061
 |  | 7. Microlease | Howard Peat | 32THoward.peat@microlease.com32T | 07885 464912
 |  | 8. SJ Electronics | Melvin Crane | 32Tm.crane@sjelectronics.co.uk32T | 07764 763216
 |  | 9. Thurlby Thandar | Gary Crowther | 32Tgary.crowther@ttid.co.uk32T
4 | Batteries | 1.City Electrical Factors | Paul Nightingale | 32Tnato@cef.co.uk32T | 01733 402816
 |  | 2. Farnell Onecall | Michael Reeks | 32Tmreeks@premierfarnell.com32T | 07920 419 500
 |  | 3.Rapid Electronics | Chris Calver | 32Tchris.calver@rapidonline.com32T | 01206 838020
 |  | 4. Rexel | Tom Norris | 32Ttom.Norris@rexel.co.uk32T | 07741 291484
 |  | 5. RS Components | Kudzai Manduvi | 32TKudzai.manduvi@rs-components.com32T | 07827 841519
 |  | 6. Allbatteries | Rebecca Reade | 32TRebecca.reade@allbatteries.com32T | 0121 506 8625
 |  | 7. H-Squared | Marissa Stoneham | 32Tmarissastoneham@h-squared.co.uk32T | 01462 815115
 |  | 8.Screwfix Direct | Zoe Harris | 32TZoe.harris@screwfix.com32T | 01935 441767
 |  | 9.YESSS Electrical | Giles Parker | 32Tnationalaccounts@yesss.co.uk32T | 07854 366814
Approved Suppliers
City Electrical Factors
Farnell
Rapid Electronics
Rexel
RS Components
Screwfix Direct
YESSS Ltd
Lambda Photometrics
Microlease
SJ Electronics
Thurlby Thandar
Allbatteries
H-Squared
Mouser
Robotshop
Pimoroni
Non-approved supplier
Direct Plastics
Smith Metals

Sheet: Purchase
Team 3
Item to purchase
Item No | Description | Category | Quantity | Price (exc. VAT) | Price (inc. VAT) | Item link | Proceed (Y/N) | Date | Remarks/Reason
example | DURATOOL Threaded Rod M12 | Motors and actuator | 1 | £6.97 | £8.36 | https://uk.farnell.com/duratool/rod12/studding-steel-m12/dp/2444309#anchorTechnicalDOCS | n | 28/10/24 | Lead screw testing
1 | RPI5-8GB-SINGLE | Controls | 1 | £61.07 | £73.28 | https://uk.farnell.com/raspberry-pi/rpi5-8gb-single/raspberry-pi-5-model-b-8gb-2-4ghz/dp/4256000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 | y | 2024-07-11
2 | Raspberry Pi Camera Module 3 | Sensors | 1 | £19.23 | £23.08 | https://uk.farnell.com/raspberry-pi/sc0872/rpi-camera-mod-3-standard-lens/dp/4132318 | y | 2024-07-11
3 | RS Pro Timing Belt 6mm, 115.82mm | Motors and actuator | 1 | £1.62 | £1.94 | https://uk.rs-online.com/web/p/timing-belts/7785039 | y | 2024-08-11
4 | Timing Belt Pulley 32 Tooth | Motors and actuator | 1 | £5.10 | £6.12 | https://uk.rs-online.com/web/p/belt-pulleys/2362817?gb=s | y | 2024-08-11
5 | Timing Belt Pulley 12 Tooth | Motors and actuator | 1 | £3.40 | £4.08 | https://uk.rs-online.com/web/p/belt-pulleys/2362767?gb=s | y | 2024-08-11
6 | Threaded Rod M10 1m | Motors and actuator | 1 | £6.15 | £7.38 | https://uk.farnell.com/duratool/rod10/studding-steel-m10/dp/2444308 | y | 2024-08-11
7 | M10 Hex Nut (50) | Motors and actuator | 1 | £5.66 | £6.79 | https://uk.farnell.com/tr-fastenings/m10-hfst-z50/full-nut-steel-bzp-m10-pk50/dp/1419453 | y | 2024-08-11
8 | Train ticket to Amentum | Others | 1 | £40.80 | £40.80 |  | y | 2024-08-11 | Visit to Amentum
9 | Nylon 66 12mm width rods 1m | Chassis | 1 | £5.83 | £7.00 | https://www.directplastics.co.uk/nylon-6-6-natural-rod-12mm-dia-x-1000mm | y | 2024-06-11
10 | Nylon 66 5mm width rods 1m | Chassis | 1 | £1.70 | £2.04 | https://www.directplastics.co.uk/nylon-6-6-natural-rod-5mm-dia-x-1000mm | y | 2024-06-11
11 | Adafruit NeoPixel LED Ring | Sensors | 1 | £10.78 | £12.94 | https://www.rapidonline.com/catalogue/search?Query=neopixel%2016 | y | 2024-06-12
12 | TF Luna Lidar | Sensors | 1 | £12.14 | £14.57 | https://www.aliexpress.com/item/1005007295663136.html?spm=a2g0o.cart.0.0.66b838daTHPtFx&mp=1 | y | 2024-07-12
13 | Threadless Aluminium Alloy Busher | Turning mechanism | 1 | £0.80 | £0.96 | https://www.aliexpress.com/item/1005007460201719.html?spm=a2g0o.cart.0.0.66b838daTHPtFx&mp=1 | y | 2024-07-12
14 | Micro Linear Actuator, 150 mm, 150 N | Motors and actuator | 1 | £12.07 | £14.48 | https://www.aliexpress.com/item/1005003526985420.html?spm=a2g0o.cart.0.0.66b838daTHPtFx&mp=1 | y | 2024-07-12
15 | Micro HDMI Cable, 5m | Sensors | 1 | £5.67 | £6.80 | https://thepihut.com/products/hdmi-to-micro-hdmi-cable-2m-gold-plated?variant=40818117083331 | y | 2025-01-31 | £3.90 delivery fee from PiHut
16 | Raspberry Pi 27W USB-C Power Supply | Others | 1 | £9.50 | £11.40 | https://thepihut.com/products/raspberry-pi-27w-usb-c-power-supply?variant=42531604103363 | y | 2025-01-31
17 | RPi 5 Camera Adapter Cable, 500mm | Sensors | 1 | £2.25 | £2.70 | https://thepihut.com/products/camera-adapter-cable-for-raspberry-pi-5?variant=42531560849603 | y | 2025-01-31
18 | Micro Linear Actuator, 150 mm, 150 N | Motors and actuator | 8 | £85.38 | £102.46 | https://www.aliexpress.com/item/1005005579542524.html?spm=a2g0o.cart.0.0.573a38daEszjvj&mp=1 | y | 2025-01-31 | Price including delivery and import tax
19 | M6 Threaded Inserts, 9mm, pack of 20 | Chassis | 1 | £6.62 | £7.95 | https://www.123-3d.co.uk/123-3D-M6-thread-inserts-9mm-x-9mm-20-pack-i6876-t9745.html | y | 2025-01-31
20 | GT2 9mm Timing Belt, 2.5m | Chassis | 1 | £13.96 | £16.75 | https://www.123-3d.co.uk/123-3D-GT2-9mm-timing-belt-2-5-metres-i6550-t0.html | y | 2025-01-31
21 | M6 Threaded Rod, 1m | Chassis | 1 | £4.58 | £5.50 | https://www.123-3d.co.uk/123-3D-M6-threaded-rod-100cm-i2226-t0.html | y | 2025-01-31
22 | Grub Screws, M4x8mm, pack of 10 | Chassis | 2 | £3.75 | £4.50 | https://www.123-3d.co.uk/123-3D-Grub-screws-M4-x-8mm-10-pack-i3103-t0.html | y | 2025-01-31
23 | M6 Nut, pack of 50 | Chassis | 1 | £2.75 | £3.30 | https://www.123-3d.co.uk/123-3D-Zinc-plated-hexagon-M6-nut-50-pack-i142-t0.html | y | 2025-01-31
24 | M6 Lock Nut, pack of 50 | Chassis | 1 | £3.08 | £3.70 | https://www.123-3d.co.uk/123-3D-Zinc-plated-M6-lock-nut-50-pack-i144-t0.html | y | 2025-01-31
25 | GT2 Timing Belt Pulley, 20 teeth, 9mm belt, 8mm bore | Chassis | 7 | £30.62 | £36.75 | https://www.123-3d.co.uk/123-3D-GT2-timing-belt-pulley-20-teeth-9mm-belt-8mm-bore-GT2-20T-W9-B8-i2306-t0.html | y | 2025-01-31
26 | Bevel Gear, 5mm bore, 10 teeth | Chassis | 1 | £5.31 | £6.37 | https://uk.rs-online.com/web/p/mitre-bevel-gears/1828012?gb=s | y | 2025-01-31
27 | 3M UV Safety glasses , PC Lens | Turning mechanism | 2 | £4.32 | £5.18 | https://uk.rs-online.com/web/p/safety-glasses/1849475?gb=s | y | 2025-02-11 | H&S equipment for build
28 | Portwest Grey Polyurethane Cut Resistant Gloves | Turning mechanism | 2 | £8.00 | £9.60 | https://uk.rs-online.com/web/p/work-gloves/2372807?gb=s | y | 2025-02-11 | H&S equipment for build
29 | RS PRO M3 Brass Threaded Inserts, 4mm depth, 4.78mm (Pack of 100) | Turning mechanism | 1 | £16.67 | £20.00 | https://uk.rs-online.com/web/p/threaded-inserts/0278584?gb=s | y | 2025-02-11
30 | Polycarbonate sheet 250x250x3mm | Chassis | 3 | £9.90 | £11.88 | https://www.directplastics.co.uk/lexan-polycarb-sheet-250-x-250-x-3mm | y | 2025-02-11
31 | Polycarbonate sheet 100x500x3mm | Turning mechanism | 1 | £21.78 | £26.14 | https://www.directplastics.co.uk/lexan-polycarb-sheet-1000-x-500-x-3mm | y | 2025-02-11
32 | XL4015 DC-DC 5A Adjustable Step Down Power Supply Module | Others | 5 | £12.79 | £15.35 | https://www.switchelectronics.co.uk/products/xl4015-dc-dc-5a-adjustable-step-down-power-supply-module-4-38v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 | y | 2025-02-11
33 | L9110S H-Bridge Dual Channel Motor Driver | Others | 8 | £8.87 | £10.64 | https://www.switchelectronics.co.uk/products/l9110s-h-bridge-dual-dc-motor-driver-controller-module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 | y | 2025-02-11
34 | 1.1A PTC Resettable Fuse 30V | Others | 8 | £4.20 | £5.04 | https://www.switchelectronics.co.uk/products/1-1a-ptc-resettable-fuse-30v-mf-r110-0-99?variant=45454307295541 | y | 2025-02-11
35 | 3-Way Single Row PCB Socket 2.54mm | Others | 16 | £2.93 | £3.52 | https://www.switchelectronics.co.uk/products/3-way-single-row-pcb-socket-2-54mm?variant=45606357074229 | y | 2025-02-11
36 | 10-Way 3.81mm PCB Terminal 10A 150V | Others | 12 | £10.80 | £12.96 | https://www.switchelectronics.co.uk/products/10-way-3-81mm-pcb-terminal-block-green-10a-150v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 | y | 2025-02-11
37 | 40-Way Double Row PCB Socket 2.54mm | Others | 2 | £0.93 | £1.12 | https://www.switchelectronics.co.uk/products/40-way-double-row-pcb-socket-2-54mm?variant=45606359925045 | y | 2025-02-11
38 | 20-Way Single Row PCB Socker 2.54mm | Others | 5 | £2.15 | £2.58 | https://www.switchelectronics.co.uk/products/20-way-single-row-pcb-socket-2-54mm?variant=45606357303605 | y | 2025-02-11
39 | Spring Steel 2x40x1000x2 CS95 Carbon Steel | Turning mechanism | 1 | £21.67 | £26.00 | https://www.ebay.co.uk/itm/315051934625 | y | 2025-02-11 | £12 delivery fee
40 | RS PRO Bevel Gear, 5mm bore, 15 teeth, 1.0 module (pack of 3) | Chassis | 1 | £6.36 | £7.63 | https://uk.rs-online.com/web/p/mitre-bevel-gears/1828002?gb=s | y | 2025-02-21
41 | RS PRO Bevel Gear, 8mm bore, 30 teeth, 1.0 module | Chassis | 1 | £5.81 | £6.97 | https://uk.rs-online.com/web/p/mitre-bevel-gears/1827994?gb=s | y | 2025-02-21
42 | Raspberry Pi 2MB SC0917 Pico H 32-bit | Controls | 1 | £4.04 | £4.85 | https://www.rapidonline.com/raspberry-pi-2mb-sc0917-pico-h-32-bit-soc-singles-75-1230 | y | 2025-02-21
43 | Silicone Mold Making Kit 20A, Translucent, 38oz | Chassis | 1 | £22.49 | £31.48 | https://www.amazon.co.uk/gp/product/B0CWV2TLYM/ref=ox_sc_act_title_1?smid=A20DQN62VE7VKX&th=1 | y | 2025-02-21 | £4.49 shipping fee
44 | BNO055 9DOF Magnetic Field Module | Sensors | 1 | £12.68 | £15.21 | https://www.amazon.co.uk/gp/product/B0DKFXSNDX/ref=ox_sc_act_title_2?smid=A2BTFLBJACKCFQ&psc=1 | y | 2025-02-21
45 | VL53L1X Flight Time Sensors Module | Sensors | 2 | £11.45 | £17.74 | https://www.amazon.co.uk/gp/product/B0DQXCTFTQ/ref=ox_sc_act_title_3?smid=AWD28J313WSQU&psc=1 | y | 2025-02-21 | £4 shipping fee
46 | 100m Fishing Line, 0.5mm Monofilament Clear Nylon Fishing Line | Turning mechanism | 1 | £3.40 | £4.08 | https://www.amazon.co.uk/gp/product/B0BG2P8C16/ref=ox_sc_act_title_4?smid=A1YB9N4NYOGGKS&psc=1 | y | 2025-02-21
47 | TF Luna Lidar | Sensors | 1 | £16.42 | £19.70 | https://www.mouser.co.uk/ProductDetail/Benewake/TF-Luna-I2C?qs=DPoM0jnrROUWvdDwJYVpzw%3D%3D | y | 2025-02-21
48 | Shift Register 8-bit - 74HC595 | Controls | 6 | £10.75 | £12.90 | https://shop.pimoroni.com/products/shift-register-8-bit-74hc595?variant=27861668167 | y | 2025-03-04 | £3.25 shipping fee
49 | Wire-to board Terminal Block, Screwless, 5mm, 2-way | Others | 10 | £5.45 | £6.54 | https://uk.farnell.com/te-connectivity/2834076-1/tb-wire-to-board-2pos-28-14awg/dp/2610397 | y | 2025-03-04
50 | TruPower CQ-122N Mini Automotive Fuseholder | Others | 10 | £4.59 | £5.51 | https://www.rapidonline.com/trupower-cq-122n-mini-automotive-fuseholder-26-2470 | y | 2025-03-04
51 | CamdenBoss 2 way, 10A, Interlocking Terminal Block, 3.81mm pitch | Others | 7 | £9.45 | £11.34 | https://www.rapidonline.com/camdenboss-ctb0308-2-2-way-10a-interlocking-terminal-block-3-81mm-pitch-21-1655 | y | 2025-03-04
52 | Sealey Automotive Standard Blade Fuse 5A (pack of 50) | Others | 1 | £1.99 | £2.39 | https://www.rapidonline.com/sealey-sbf550-automotive-standard-blade-fuse-5a-pack-of-50-84-0518 | y | 2025-03-04
53 | ROD6 Duratool M6, 1mm pitch, 1m length | Chassis | 1 | £3.00 | £3.60 | https://uk.farnell.com/duratool/rod6/studding-steel-m6/dp/2444306 | y | 2025-10-03
54 | Sealey MBF550 Automotive MINI Blade Fuse 5A (pack of 50) | Others | 1 | £2.13 | £2.56 | https://www.rapidonline.com/sealey-mbf550-automotive-mini-blade-fuse-5a-pack-of-50-84-0506 | y | 2025-10-03
55 | ACS712 Hall Board Current Sensor Module 5A | Sensors | 8 | £12.03 | £14.44 | https://kunkune.co.uk/shop/arduino-sensors/acs712-hall-board-current-sensor-module-5a-20a-30a/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 | y | 17/3/2025
56 | L9110S H-Bridge Dual DC Stepper Motor Controller Board (pack of 5) | Others | 1 | £4.08 | £4.90 | https://kunkune.co.uk/shop/servo-motors-and-shields/5x-l9110s-h-bridge-dual-dc-stepper-motor-controller-board/ | y | 17/3/2025
57 | 4 pcs 50kg Load Cell with HX711 Amplifier | Sensors | 1 | £4.92 | £5.90 | https://kunkune.co.uk/shop/arduino-sensors/4pcs-50kg-load-cell-with-hx711-amplifier/ | y | 17/3/2025
58 | HX711 Weight Pressure Sensor | Sensors | 1 | £2.42 | £2.90 | https://kunkune.co.uk/shop/arduino-sensors/hx711-weight-pressure-sensor/ | y | 17/3/2025
59 | Polycarbonate Clear 250x250x2mm | Chassis | 8 | £17.60 | £21.12 | https://www.directplastics.co.uk/lexan-polycarb-sheet-250-x-250-x-2mm | y | 17/3/2025
60 | Micro Linear Actuator, 150mm stroke, 150N | Motors and actuator | 8 | £72.36 | £86.83 | https://www.aliexpress.com/item/1005005579542524.html?mp=1 | y | 17/3/2025
61 | Micro Linear Actuator, 100mm stroke, 150N | Motors and actuator | 2 | £32.98 | £39.58 | https://www.aliexpress.com/item/1005006111039906.html?mp=1 | y | 17/3/2025
62 | SER0046 Micro Servo | Motors and actuator | 2 | £11.90 | £14.28 | https://uk.farnell.com/dfrobot/ser0046/servo-motor-270deg-1-47n-m-6v/dp/3769942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 | y | 28/3/2025
63 | Raspberry Pi Pico H | Controls | 2 | £7.94 | £9.53 | https://uk.farnell.com/raspberry-pi/raspberry-pi-pico-h/raspberry-pi-board-arm-cortex/dp/3996081 | y | 28/3/2025
64 | Bourns 3690 10kOhm Rotary Potentiometer | Sensors | 2 | £26.88 | £32.26 | https://uk.rs-online.com/web/p/potentiometers/1070785?gb=s | y | 28/3/2025
65 | Adafruit 9-DoF Absolute Orientation IMU BNO055 | Sensors | 1 | £19.68 | £23.62 | https://www.mouser.co.uk/ProductDetail/Adafruit/4646?qs=W%2FMpXkg%252BdQ4Msqspav40iw%3D%3D | y | 28/3/2025
66 | Distance Sensor VL53L1X ToF Sensor Breakout | Sensors | 2 | £25.10 | £30.12 | https://www.mouser.co.uk/ProductDetail/Pimoroni/PIM373?qs=lc2O%252BfHJPVbu7kI%2FlA0xSg%3D%3D | y | 28/3/2025
67 | Carbon Fibre Solid Rod 5x500 | Chassis | 4 | £9.44 | £11.33 | https://www.rapidonline.com/carbon-fibre-solid-rod-5x500mm-50-8872 | y | 14/04/2025
68 | CD74HC4067M96 Multiplexer Switch IC | Sensors | 10 | £2.78 | £3.34 | https://www.mouser.co.uk/ProductDetail/Texas-Instruments/CD74HC4067M96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 | y | 14/04/2025
69 | Micro Linear Actuator 12VDC, A Type 150mm, 150N 4mm/s | Motors and actuator | 2 | £18.48 | £22.18 | https://www.aliexpress.com/item/1005005579542524.html?mp=1 | y | 14/04/2025 | £5.79 shipping fee
70 | Small Linear Actuator, 12V 75mm stroke, Load 70N | Motors and actuator | 2 | £31.65 | £37.98 | https://www.aliexpress.com/item/1005006111039906.html?mp=1 | y | 14/04/2025
71 | VL53L1X ToF Sensor | Sensors | 2 | £4.00 | £4.80 | https://www.aliexpress.com/item/1005005643165013.html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 | y | 14/04/2025
72 | BNO055 9DOF Absolute Orientation Breakout Board | Sensors | 1 | £5.49 | £6.59 | https://www.aliexpress.com/item/1005005499172228.html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 | y | 14/04/2025
73 | Miniature Ball Bearing, 6x17x6mm (10 units) | Turning mechanism | 1 | £2.51 | £3.01 | https://www.aliexpress.com/item/1005007668446060.html?mp=1 | y | 14/04/2025
74 | 40 kg Digital Servo High Voltage High Torque Metal Gear 360 Continuous Rotation | Turning mechanism | 3 | £75.45 | £90.54 | https://www.amazon.co.uk/DIYmall-Coreless-Continuous-Rotation-Helicopter/dp/B0DNM3Q1MQ | y | 28/04/2025 | Only 2 arrived
75 | Polycarbonate Clear 1200x600x2mm | Chassis | 1 | £19.08 | £22.90 | https://www.directplastics.co.uk/lexan-polycarb-sheet-1200-x-600-x-2mm | y | 2025-05-06
76 | Wire-to-Board Terminal Block, 2.54 mm, 8 ways, MP008517 | Others | 6 | £6.00 | £7.20 | https://uk.farnell.com/multicomp-pro/mp008517/tb-wire-to-brd-r-a-8way-18awg/dp/3817464?cfm=true | y | 2025-05-15
77 | Wire-to-Board Terminal Block, 2.54 mm, 6 ways, MP008516 | Others | 6 | £7.56 | £9.07 | https://uk.farnell.com/multicomp-pro/mp008516/tb-wire-to-brd-r-a-6way-18awg/dp/3817463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 | y | 2025-05-15
78 | 25T Steering Gear Servo Winch Wheel Drum for 1/10 RC Crawler Car | Turning mechanism | 2 | £13.72 | £16.47 | https://www.amazon.co.uk/CENPEK-Steering-Crawler-Traxxsa-Tamiay/dp/B09H73VWZY?s=kids | y | 2025-05-15 | £4.49 delivery fee
79 | 4Pcs INA219 I2C Interface Bi-Directional DC Current Power Supply Sensor | Sensors | 5 | £37.46 | £44.95 | https://www.amazon.co.uk/dp/B0CP73P31R?previewDoh=1 | y | 2025-05-20
 |  |  |  |  | £0.00
 |  |  |  |  | £0.00
 |  |  |  |  | £0.00

Sheet: Spending tracker
Team 3
Spending tracker
Item ID | Description | Category | Order date | Quantity | Item cost (exc. VAT) | Item cost (inc. VAT) | Remarks | Order received
1 | RPI5-8GB-SINGLE | Controls | 2024-08-11 | 1 | £61.07 | £73.28 |  | TRUE
2 | Raspberry Pi Camera Module 3 | Sensors | 2024-08-11 | 1 | £19.23 | £23.08 |  | TRUE
3 | RS Pro Timing Belt 6mm, 115.82mm | Motors and actuator | 2024-08-11 | 1 | £1.62 | £1.94 |  | TRUE
4 | Timing Belt Pulley 32 Tooth | Motors and actuator | 2024-08-11 | 1 | £5.10 | £6.12 |  | TRUE
5 | Timing Belt Pulley 12 Tooth | Motors and actuator | 2024-08-11 | 1 | £3.40 | £4.08 |  | TRUE
6 | Threaded Rod M10 1m | Motors and actuator | 2024-08-11 | 1 | £6.15 | £7.38 |  | TRUE
7 | M10 Hex Nut (50) | Motors and actuator | 2024-08-11 | 1 | £5.66 | £6.79 |  | TRUE
8 | Train ticket to Amentum | Others | 2024-08-11 | 1 | £40.80 | £40.80 |  | TRUE
9 | Nylon 66 12mm width rods 1m | Chassis | 2024-11-06 | 1 | £5.83 | £7.00 |  | TRUE
10 | Nylon 66 5mm width rods 1m | Chassis | 2024-11-06 | 1 | £1.70 | £2.04 |  | TRUE
11 | Adafruit NeoPixel LED Ring | Sensors | 2024-12-07 | 1 | £10.78 | £12.94 |  | TRUE
12 | TF Luna Lidar | Sensors | 2024-12-07 | 1 | £12.14 | £14.57 |  | TRUE
13 | Threadless Aluminium Alloy Busher | Turning mechanism | 2024-12-07 | 1 | £0.80 | £0.96 |  | TRUE
14 | Micro Linear Actuator, 150 mm, 150 N | Motors and actuator | 2024-12-07 | 1 | £12.07 | £14.48 |  | TRUE
15 | Micro HDMI Cable, 5m | Sensors | 2025-01-31 | 1 | £5.67 | £6.80 |  | TRUE
16 | Raspberry Pi 27W USB-C Power Supply | Others | 2025-01-31 | 1 | £9.50 | £11.40 |  | TRUE
17 | RPi 5 Camera Adapter Cable, 500mm | Sensors | 2025-01-31 | 1 | £2.25 | £2.70 |  | TRUE
18 | Micro Linear Actuator, 150 mm, 150 N | Motors and actuator | 2025-01-31 | 8 | £85.38 | £102.46 |  | TRUE
19 | M6 Threaded Inserts, 9mm, pack of 20 | Chassis | 2025-01-31 | 1 | £6.62 | £7.95 |  | TRUE
20 | GT2 9mm Timing Belt, 2.5m | Chassis | 2025-01-31 | 1 | £13.96 | £16.75 |  | TRUE
21 | M6 Threaded Rod, 1m | Chassis | 2025-01-31 | 1 | £4.58 | £5.50 |  | TRUE
22 | Grub Screws, M4x8mm, pack of 10 | Chassis | 2025-01-31 | 2 | £3.75 | £4.50 |  | TRUE
23 | M6 Nut, pack of 50 | Chassis | 2025-01-31 | 1 | £2.75 | £3.30 |  | TRUE
24 | M6 Lock Nut, pack of 50 | Chassis | 2025-01-31 | 1 | £3.08 | £3.70 |  | TRUE
25 | GT2 Timing Belt Pulley, 20 teeth, 9mm belt, 8mm bore | Chassis | 2025-01-31 | 7 | £30.62 | £36.75 |  | TRUE
26 | Bevel Gear, 5mm bore, 10 teeth | Chassis | 2025-01-31 | 1 | £5.31 | £6.37 | Order cancelled | FALSE
27 | 3M UV Safety glasses , PC Lens | Turning mechanism | 2025-02-11 | 2 | £4.32 | £5.18 |  | TRUE
28 | Portwest Grey Polyurethane Cut Resistant Gloves | Turning mechanism | 2025-02-11 | 2 | £8.00 | £9.60 | Order cancelled | FALSE
29 | RS PRO M3 Brass Threaded Inserts, 4mm depth, 4.78mm (Pack of 100) | Turning mechanism | 2025-02-11 | 1 | £16.67 | £20.00 |  | TRUE
30 | Polycarbonate sheet 250x250x3mm | Chassis | 2025-02-11 | 3 | £9.90 | £11.88 |  | TRUE
31 | Polycarbonate sheet 100x500x3mm | Turning mechanism | 2025-02-11 | 1 | £21.78 | £26.14 |  | TRUE
32 | XL4015 DC-DC 5A Adjustable Step Down Power Supply Module | Others | 2025-02-11 | 5 | £12.79 | £15.35 |  | TRUE
33 | L9110S H-Bridge Dual Channel Motor Driver | Others | 2025-02-11 | 8 | £8.87 | £10.64 |  | TRUE
34 | 1.1A PTC Resettable Fuse 30V | Others | 2025-02-11 | 8 | £4.20 | £5.04 |  | TRUE
35 | 3-Way Single Row PCB Socket 2.54mm | Others | 2025-02-11 | 16 | £2.93 | £3.52 |  | TRUE
36 | 10-Way 3.81mm PCB Terminal 10A 150V | Others | 2025-02-11 | 12 | £10.80 | £12.96 |  | TRUE
37 | 40-Way Double Row PCB Socket 2.54mm | Others | 2025-02-11 | 2 | £0.93 | £1.12 |  | TRUE
38 | 20-Way Single Row PCB Socker 2.54mm | Others | 2025-02-11 | 5 | £2.15 | £2.58 |  | TRUE
39 | Spring Steel 2x40x1000x2 CS95 Carbon Steel | Turning mechanism | 2025-02-11 | 1 | £21.67 | £26.00 |  | TRUE
40 | RS PRO Bevel Gear, 5mm bore, 15 teeth, 1.0 module (pack of 3) | Chassis | 2025-02-21 | 1 | £6.36 | £7.63 |  | TRUE
41 | RS PRO Bevel Gear, 8mm bore, 30 teeth, 1.0 module | Chassis | 2025-02-21 | 1 | £5.81 | £6.97 |  | TRUE
42 | Raspberry Pi 2MB SC0917 Pico H 32-bit | Controls | 2025-02-21 | 1 | £4.04 | £4.85 |  | TRUE
43 | Silicone Mold Making Kit 20A, Translucent, 38oz | Chassis | 2025-02-21 | 1 | £22.49 | £26.99 |  | TRUE
44 | BNO055 9DOF Magnetic Field Module | Sensors | 2025-02-21 | 1 | £12.68 | £15.21 |  | TRUE
45 | VL53L1X Flight Time Sensors Module | Sensors | 2025-02-21 | 2 | £11.45 | £13.74 |  | TRUE
46 | 100m Fishing Line, 0.5mm Monofilament Clear Nylon Fishing Line | Turning mechanism | 2025-02-21 | 1 | £3.40 | £4.08 |  | TRUE
47 | TF Luna Lidar | Sensors | 2025-02-21 | 1 | £16.42 | £19.70 |  | TRUE
48 | Shift Register 8-bit - 74HC595 | Controls | 2025-03-04 | 6 | £10.75 | £12.90 |  | TRUE
49 | Wire-to board Terminal Block, Screwless, 5mm, 2-way | Others | 2025-03-04 | 10 | £5.45 | £6.54 |  | TRUE
50 | TruPower CQ-122N Mini Automotive Fuseholder | Others | 2025-03-04 | 10 | £4.59 | £5.51 |  | TRUE
51 | CamdenBoss 2 way, 10A, Interlocking Terminal Block, 3.81mm pitch | Others | 2025-03-04 | 7 | £9.45 | £11.34 |  | TRUE
52 | Sealey Automotive Standard Blade Fuse 5A (pack of 50) | Others | 2025-03-04 | 1 | £1.99 | £2.39 |  | TRUE
53 | ROD6 Duratool M6, 1mm pitch, 1m length | Chassis | 2025-03-10 | 1 | £3.00 | £3.60 |  | TRUE
54 | Sealey MBF550 Automotive MINI Blade Fuse 5A (pack of 50) | Others | 2025-03-10 | 1 | £2.13 | £2.56 |  | TRUE
55 | ACS712 Hall Board Current Sensor Module 5A | Sensors | 2025-03-17 | 8 | £12.03 | £14.44 |  | TRUE
56 | L9110S H-Bridge Dual DC Stepper Motor Controller Board (pack of 5) | Others | 2025-03-17 | 1 | £4.08 | £4.90 |  | TRUE
57 | 4 pcs 50kg Load Cell with HX711 Amplifier | Sensors | 2025-03-17 | 1 | £4.92 | £5.90 |  | TRUE
58 | HX711 Weight Pressure Sensor | Sensors | 2025-03-17 | 1 | £2.42 | £2.90 |  | TRUE
59 | Polycarbonate Clear 250x250x2mm | Chassis | 2025-03-17 | 8 | £17.60 | £21.12 |  | TRUE
60 | Micro Linear Actuator, 150mm stroke, 150N | Motors and actuator | 2025-03-17 | 8 | £72.36 | £86.83 |  | TRUE
61 | Micro Linear Actuator, 100mm stroke, 150N | Motors and actuator | 2025-03-17 | 2 | £32.98 | £39.58 |  | TRUE
62 | SER0046 Micro Servo | Motors and actuator | 2025-03-28 | 2 | £11.90 | £14.28 |  | TRUE
63 | Raspberry Pi Pico H | Controls | 2025-03-28 | 2 | £7.94 | £9.53 |  | TRUE
64 | Bourns 3690 10kOhm Rotary Potentiometer | Sensors | 2025-03-28 | 2 | £26.88 | £32.26 |  | TRUE
65 | Adafruit 9-DoF Absolute Orientation IMU BNO055 | Sensors | 2025-03-28 | 1 | £19.68 | £23.62 |  | TRUE
66 | Distance Sensor VL53L1X ToF Sensor Breakout | Sensors | 2025-03-28 | 2 | £25.10 | £30.12 |  | TRUE
67 | Carbon Fibre Solid Rod 5x500 | Chassis | 2025-03-14 | 4 | £9.44 | £11.33 |  | TRUE
68 | CD74HC4067M96 Multiplexer Switch IC | Sensors | 2025-03-14 | 10 | £2.78 | £3.34 |  | TRUE
69 | Micro Linear Actuator 12VDC, A Type 150mm, 150N 4mm/s | Motors and actuator | 2025-03-14 | 2 | £18.48 | £22.18 |  | TRUE
70 | Small Linear Actuator, 12V 75mm stroke, Load 70N | Motors and actuator | 2025-03-14 | 2 | £31.65 | £37.98 |  | TRUE
71 | VL53L1X ToF Sensor | Sensors | 2025-03-14 | 2 | £4.00 | £4.80 |  | TRUE
72 | BNO055 9DOF Absolute Orientation Breakout Board | Sensors | 2025-03-14 | 1 | £5.49 | £6.59 |  | TRUE
73 | Miniature Ball Bearing, 6x17x6mm (10 units) | Turning mechanism | 2025-03-14 | 1 | £2.51 | £3.01 |  | TRUE
74 | 40 kg Digital Servo High Voltage High Torque Metal Gear 360 Continuous Rotation | Turning mechanism | 2025-04-28 | 3 | £75.45 | £90.54 | Only 2 arrived | TRUE
75 | Polycarbonate Clear 1200x600x2mm | Chassis | 2025-05-15 | 1 | £19.08 | £22.90 |  | TRUE
76 | Wire-to-Board Terminal Block, 2.54 mm, 8 ways, MP008517 | Others | 2025-05-15 | 6 | £6.00 | £7.20 | Did not arrive | FALSE
77 | Wire-to-Board Terminal Block, 2.54 mm, 6 ways, MP008516 | Others | 2025-05-15 | 6 | £7.56 | £9.07 |  | TRUE
78 | 25T Steering Gear Servo Winch Wheel Drum for 1/10 RC Crawler Car | Turning mechanism | 2025-05-15 | 2 | £13.72 | £16.47 |  | TRUE
79 | 4Pcs INA219 I2C Interface Bi-Directional DC Current Power Supply Sensor | Sensors | 2025-05-20 | 5 | £37.46 | £44.95 |  | TRUE
 |  |  |  |  |  | £0.00 |  | FALSE
 |  |  |  |  | Total cost (exc. VAT) | £1076.36
 |  |  |  |  | Total cost (inc. VAT) | £1283.47
 |  |  |  |  | Budget remaining | £366.53

Sheet: Chart
 | Team 3 Budget |  | 1650
 | Balance as of | 2025-06-05 | 366.524
 | Category |  | Plan |  | Balance | Actual | Actual %
 | Motors and actuator |  | 46.0% | £759.00 | £414.90 | £344.10 | 20.85%
 | Turning mechanism |  | 15.0% | £247.50 | £36.48 | £211.02 | 12.79%
 | Sensors |  | 8.0% | £132.00 | -£145.65 | £277.65 | 16.83%
 | Chassis |  | 7.5% | £123.75 | -£73.49 | £197.24 | 11.95%
 | Controls |  | 8.5% | £140.25 | £39.69 | £100.56 | 6.09%
 | Contingency |  | 6.5% | £107.25 | £107.25 | £0.00 | 0.00%
 | Others |  | 8.5% | £140.25 | -£12.66 | £152.91 | 9.27%
 | Total |  | 100% | £1650.00 | £366.52 | £1283.48 | 77.79%
 | Purchase | Category | Date | Price
1 | RPI5-8GB-SINGLE | Controls | 2024-08-11 | £73.28
2 | Raspberry Pi Camera Module 3 | Sensors | 2024-08-11 | £23.08
3 | RS Pro Timing Belt 6mm, 115.82mm | Motors and actuator | 2024-08-11 | £1.94
4 | Timing Belt Pulley 32 Tooth | Motors and actuator | 2024-08-11 | £6.12
5 | Timing Belt Pulley 12 Tooth | Motors and actuator | 2024-08-11 | £4.08
6 | Threaded Rod M10 1m | Motors and actuator | 2024-08-11 | £7.38
7 | M10 Hex Nut (50) | Motors and actuator | 2024-08-11 | £6.79
8 | Train ticket to Amentum | Others | 2024-08-11 | £40.80
9 | Nylon 66 12mm width rods 1m | Turning mechanism | 2024-11-06 | £7.00
10 | Nylon 66 5mm width rods 1m | Turning mechanism | 2024-11-06 | £2.04
11 | Adafruit NeoPixel LED Ring | Sensors | 2024-12-07 | £12.94
12 | TF Luna Lidar | Sensors | 2024-12-07 | £14.57
13 | Threadless Aluminium Alloy Busher | Turning mechanism | 2024-12-07 | £0.96
14 | Micro Linear Actuator, 150 mm, 150 N | Motors and actuator | 2024-12-07 | £14.48
15 | Micro HDMI Cable, 5m | Sensors | 2025-01-31 | £6.80
16 | Raspberry Pi 27W USB-C Power Supply | Others | 2025-01-31 | £11.40
17 | RPi 5 Camera Adapter Cable, 500mm | Sensors | 2025-01-31 | £2.70
18 | Micro Linear Actuator, 150 mm, 150 N | Motors and actuator | 2025-01-31 | £102.46
19 | M6 Threaded Inserts, 9mm, pack of 20 | Chassis | 2025-01-31 | £7.95
20 | GT2 9mm Timing Belt, 2.5m | Chassis | 2025-01-31 | £16.75
21 | M6 Threaded Rod, 1m | Chassis | 2025-01-31 | £5.50
22 | Grub Screws, M4x8mm, pack of 10 | Chassis | 2025-01-31 | £4.50
23 | M6 Nut, pack of 50 | Chassis | 2025-01-31 | £3.30
24 | M6 Lock Nut, pack of 50 | Chassis | 2025-01-31 | £3.70
25 | GT2 Timing Belt Pulley, 20 teeth, 9mm belt, 8mm bore | Chassis | 2025-01-31 | £36.75
26 | Bevel Gear, 5mm bore, 10 teeth | Chassis | 2025-01-31 | £6.37
27 | 3M UV Safety glasses , PC Lens | Turning mechanism | 2025-02-11 | £5.18
28 | Portwest Grey Polyurethane Cut Resistant Gloves | Turning mechanism | 2025-02-11 | £9.60
29 | RS PRO M3 Brass Threaded Inserts, 4mm depth, 4.78mm (Pack of 100) | Turning mechanism | 2025-02-11 | £20.00
30 | Polycarbonate sheet 250x250x3mm | Chassis | 2025-02-11 | £11.88
31 | Polycarbonate sheet 100x500x3mm | Turning mechanism | 2025-02-11 | £26.14
32 | XL4015 DC-DC 5A Adjustable Step Down Power Supply Module | Others | 2025-02-11 | £15.35
33 | L9110S H-Bridge Dual Channel Motor Driver | Others | 2025-02-11 | £10.64
34 | 1.1A PTC Resettable Fuse 30V | Others | 2025-02-11 | £5.04
35 | 3-Way Single Row PCB Socket 2.54mm | Others | 2025-02-11 | £3.52
36 | 10-Way 3.81mm PCB Terminal 10A 150V | Others | 2025-02-11 | £12.96
37 | 40-Way Double Row PCB Socket 2.54mm | Others | 2025-02-11 | £1.12
38 | 20-Way Single Row PCB Socker 2.54mm | Others | 2025-02-11 | £2.58
39 | Spring Steel 2x40x1000x2 CS95 Carbon Steel | Turning mechanism | 2025-02-11 | £26.00
40 | RS PRO Bevel Gear, 5mm bore, 15 teeth, 1.0 module (pack of 3) | Chassis | 2025-02-21 | £7.63
41 | RS PRO Bevel Gear, 8mm bore, 30 teeth, 1.0 module | Chassis | 2025-02-21 | £6.97
42 | Raspberry Pi 2MB SC0917 Pico H 32-bit | Controls | 2025-02-21 | £4.85
43 | Silicone Mold Making Kit 20A, Translucent, 38oz | Chassis | 2025-02-21 | £26.99
44 | BNO055 9DOF Magnetic Field Module | Sensors | 2025-02-21 | £15.21
45 | VL53L1X Flight Time Sensors Module | Sensors | 2025-02-21 | £13.74
46 | 100m Fishing Line, 0.5mm Monofilament Clear Nylon Fishing Line | Turning mechanism | 2025-02-21 | £4.08
47 | TF Luna Lidar | Sensors | 2025-02-21 | £19.70
48 | Shift Register 8-bit - 74HC595 | Controls | 2025-03-04 | £12.90
49 | Wire-to board Terminal Block, Screwless, 5mm, 2-way | Others | 2025-03-04 | £6.54
50 | TruPower CQ-122N Mini Automotive Fuseholder | Others | 2025-03-04 | £5.51
51 | CamdenBoss 2 way, 10A, Interlocking Terminal Block, 3.81mm pitch | Others | 2025-03-04 | £11.34
52 | Sealey Automotive Standard Blade Fuse 5A (pack of 50) | Others | 2025-03-04 | £2.39
53 | ROD6 Duratool M6, 1mm pitch, 1m length | Chassis | 2025-03-10 | £3.60
54 | Sealey MBF550 Automotive MINI Blade Fuse 5A (pack of 50) | Others | 2025-03-10 | £2.56
55 | ACS712 Hall Board Current Sensor Module 5A | Sensors | 2025-03-17 | £14.44
56 | L9110S H-Bridge Dual DC Stepper Motor Controller Board (pack of 5) | Others | 2025-03-17 | £4.90
57 | 4 pcs 50kg Load Cell with HX711 Amplifier | Sensors | 2025-03-17 | £5.90
58 | HX711 Weight Pressure Sensor | Sensors | 2025-03-17 | £2.90
59 | Polycarbonate Clear 250x250x2mm | Chassis | 2025-03-17 | £21.12
60 | Micro Linear Actuator, 150mm stroke, 150N | Motors and actuator | 2025-03-17 | £86.83
61 | Micro Linear Actuator, 100mm stroke, 150N | Motors and actuator | 2025-03-17 | £39.58
62 | SER0046 Micro Servo | Motors and actuator | 2025-03-28 | £14.28
63 | Raspberry Pi Pico H | Controls | 2025-03-28 | £9.53
64 | Bourns 3690 10kOhm Rotary Potentiometer | Sensors | 2025-03-28 | £32.26
65 | Adafruit 9-DoF Absolute Orientation IMU BNO055 | Sensors | 2025-03-28 | £23.62
66 | Distance Sensor VL53L1X ToF Sensor Breakout | Sensors | 2025-03-28 | £30.12
67 | Carbon Fibre Solid Rod 5x500 | Chassis | 14/4/25 | £11.33
68 | CD74HC4067M96 Multiplexer Switch IC | Sensors | 14/4/25 | £3.34
69 | Micro Linear Actuator 12VDC, A Type 150mm, 150N 4mm/s | Motors and actuator | 14/4/25 | £22.18
70 | Small Linear Actuator, 12V 75mm stroke, Load 70N | Motors and actuator | 14/4/25 | £37.98
71 | VL53L1X ToF Sensor | Sensors | 14/4/25 | £4.80
72 | BNO055 9DOF Absolute Orientation Breakout Board | Sensors | 14/4/25 | £6.59
73 | Miniature Ball Bearing, 6x17x6mm (10 units) | Turning mechanism | 14/4/25 | £3.01
74 | 40 kg Digital Servo High Voltage High Torque Metal Gear 360 Continuous Rotation | Turning mechanism | 2025-04-28 | £90.54
75 | Polycarbonate Clear 1200x600x2mm | Chassis | 2025-05-06 | £22.90
76 | Wire-to-Board Terminal Block, 2.54 mm, 8 ways, MP008517 | Others | 2025-05-15 | £7.20
77 | Wire-to-Board Terminal Block, 2.54 mm, 6 ways, MP008516 | Others | 2025-05-15 | £9.07
78 | 25T Steering Gear Servo Winch Wheel Drum for 1/10 RC Crawler Car | Turning mechanism | 2025-05-15 | £16.47
79 | 4Pcs INA219 I2C Interface Bi-Directional DC Current Power Supply Sensor | Sensors | 2025-05-20 | £44.95
