georg22tech/CLInGER/CAD_and_verification/sparsAssembled v1.step

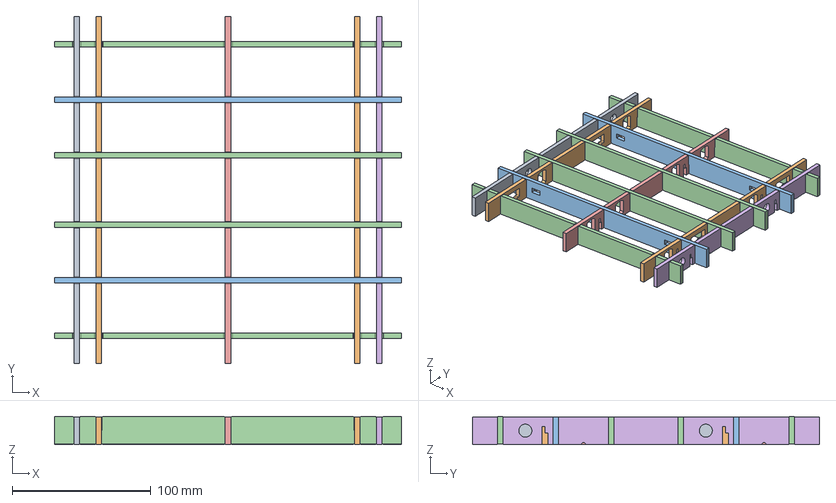
[picture p36: CAD file, 2025-06-06]
CAD_and_verification/sparsAssembled v1.step
250.0 x 250.0 x 20.2 mm
bottom_l_1
bottom_r_2
bar_top_r
bar_top_l
bar_top v1 (2) x 4
bottom_middle
bottom_l_2
bottom_r_1
