georg22tech/CLInGER/CAD_and_verification/assemblyAll.step

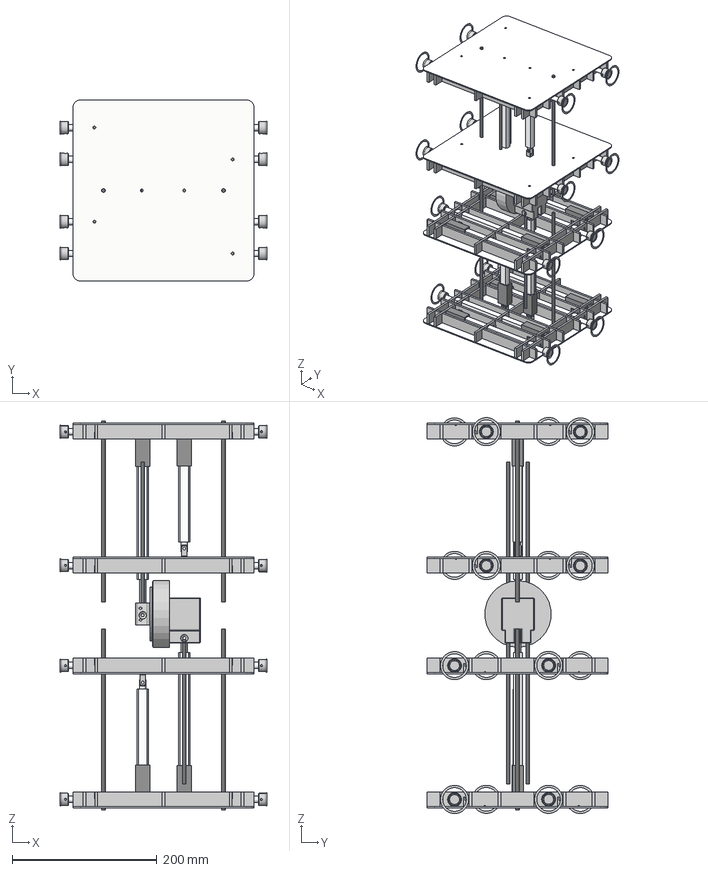
[picture p37: CAD file, 2025-06-06]
CAD_and_verification/assemblyAll.step
302.6 x 250.0 x 547.3 mm
actuator rail_100 x 2
actuator arm_100 x 2
base_1
mid_shaft
actuator rail v2
actuator arm v1
holder_1
actuator rail v2_1
actuator arm v1_1
holder_2
carbonRod_5x200 x 4
al_bushing x 62
bearing_1 x 10
bar_top v1 (2) x 16
bottom_l_1 x 4
bottom_r_2 x 4
bar_top_r x 4
bar_top_l x 4
bottom_middle x 4
bottom_l_2 x 4
bottom_r_1 x 4
encoder (4)
actuator rail v2 (3) x 4
actuator arm v1 (3) x 4
actuator rail v2 (2) x 4
actuator arm v1 (2) x 4
actuator rail v2_2 x 4
actuator arm v1_2 x 4
actuator rail v2 (1) x 4
actuator arm v1 (1) x 4
encoder (4)_1
encoder (4)_2
encoder (4)_3
act_feet_3 x 16
act_bracket x 22
carbonRod_5x250 x 4
sheet 2 (4)
sheet 2 (1)
sheet 2 (2)
sheet 2 (3)
sheet 2 x 2
