georg22tech/CLInGER/CAD_and_verification/continuum_models/L16 Linear Actuator.step

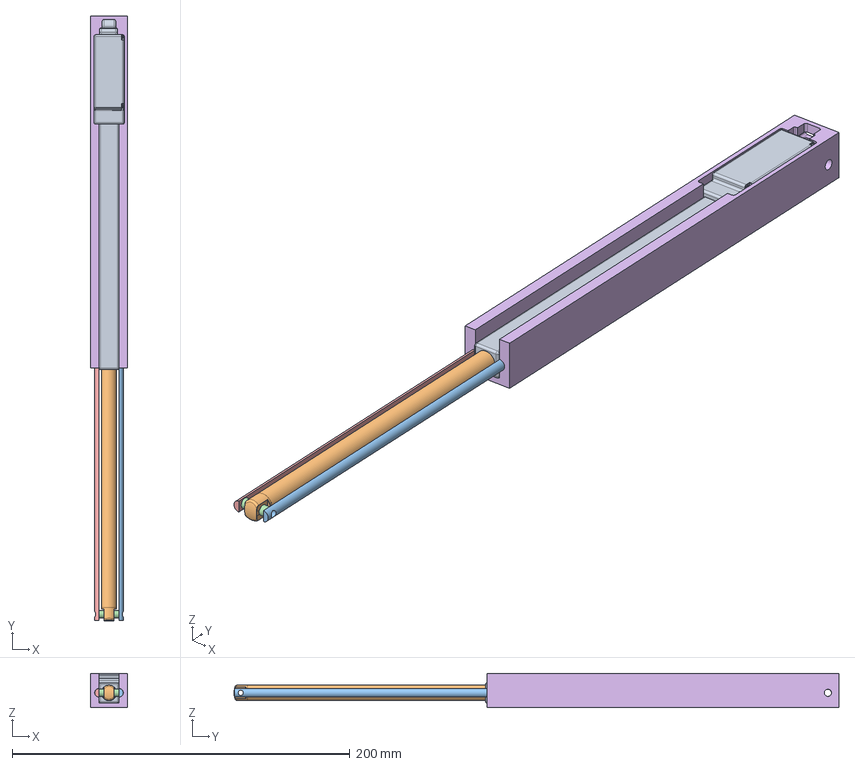
[picture p38: CAD file, 2025-06-06]
CAD_and_verification/continuum_models/L16 Linear Actuator.step
22.0 x 358.5 x 20.3 mm
L16_140MM_BODY_A
L16_140MM_LIFT_A
