georg22tech/CLInGER/CAD_and_verification/oct_solidworks_designs/frame.SLDPRT

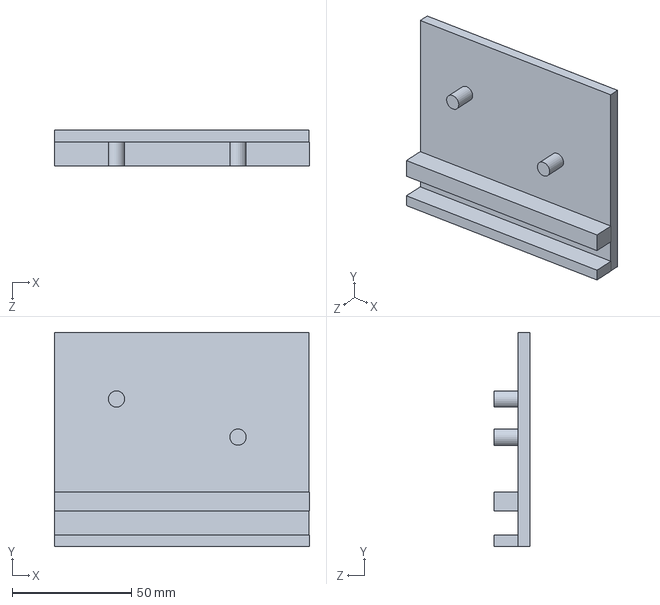
[picture p39: CAD file, 2025-06-06]
CAD_and_verification/oct_solidworks_designs/frame.SLDPRT
107.0 x 90.0 x 15.0 mm
