georg22tech/CLInGER/Control/Rasberry_pi/src/robot/meshes/arm.stl

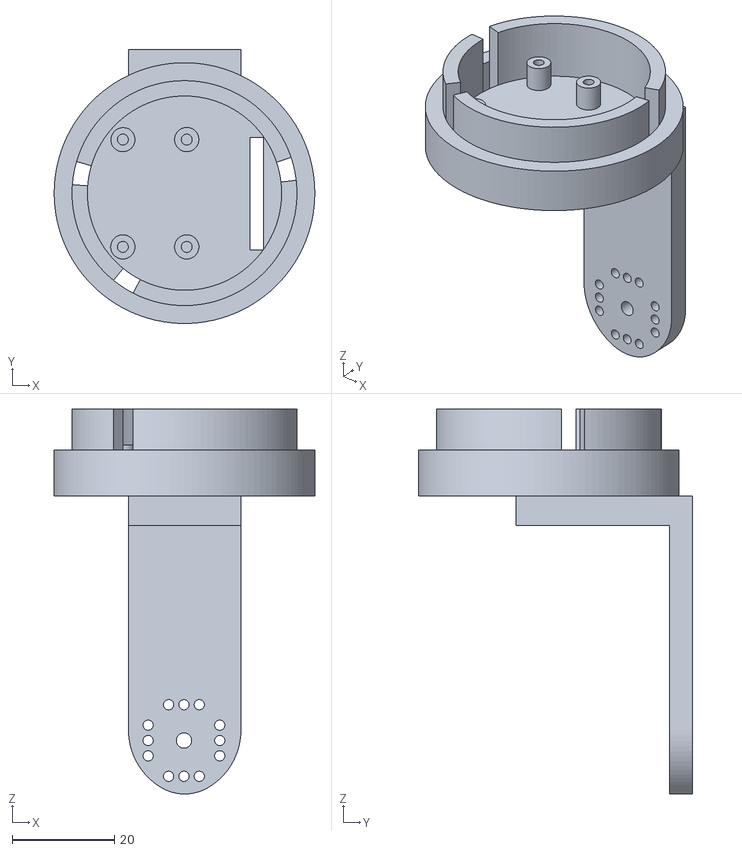
[picture p40: CAD file, 2025-06-06]
Control/Rasberry_pi/src/robot/meshes/arm.stl
51.0 x 53.6 x 75.3
