georg22tech/CLInGER/Control/Rasberry_pi/src/robot/meshes/Camera.stl

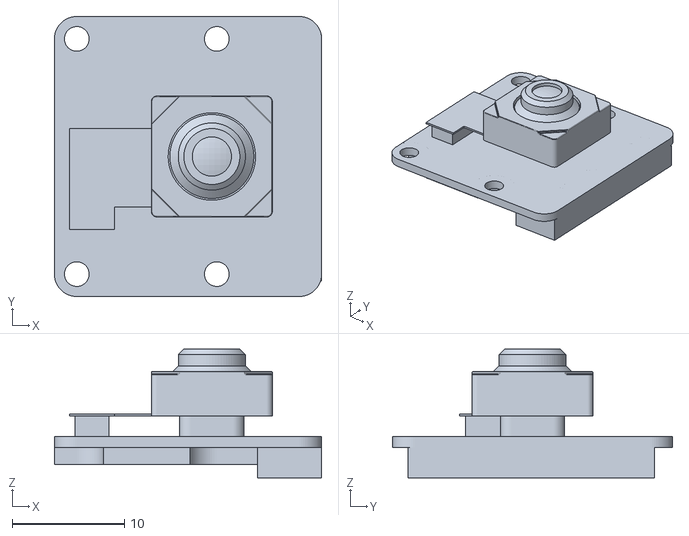
[picture p41: CAD file, 2025-06-06]
Control/Rasberry_pi/src/robot/meshes/Camera.stl
23.9 x 25.0 x 11.5
