georg22tech/CLInGER/CAD_and_verification/motorhousing.SLDPRT

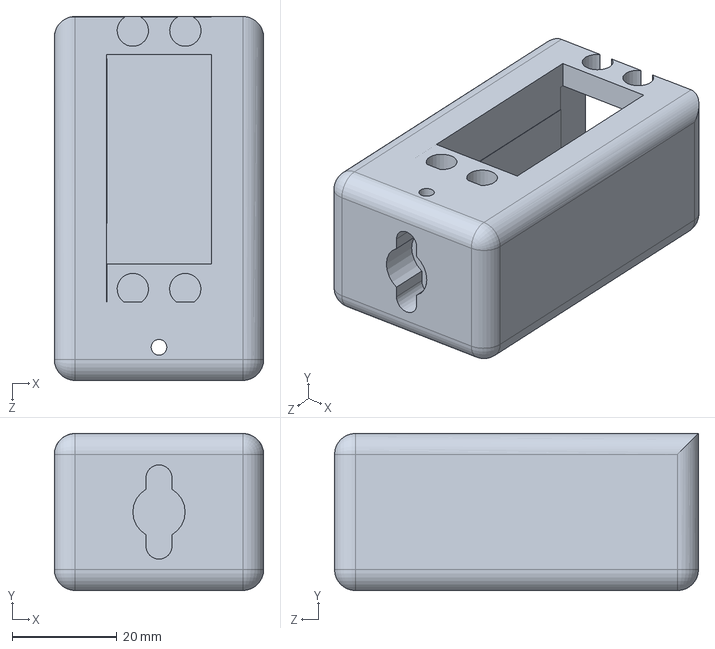
[picture p42: CAD file, 2025-06-06]
CAD_and_verification/motorhousing.SLDPRT
40.0 x 30.0 x 69.5 mm
