georg22tech/CLInGER/Control/Rasberry_pi/src/robot/meshes/LUNA.stl

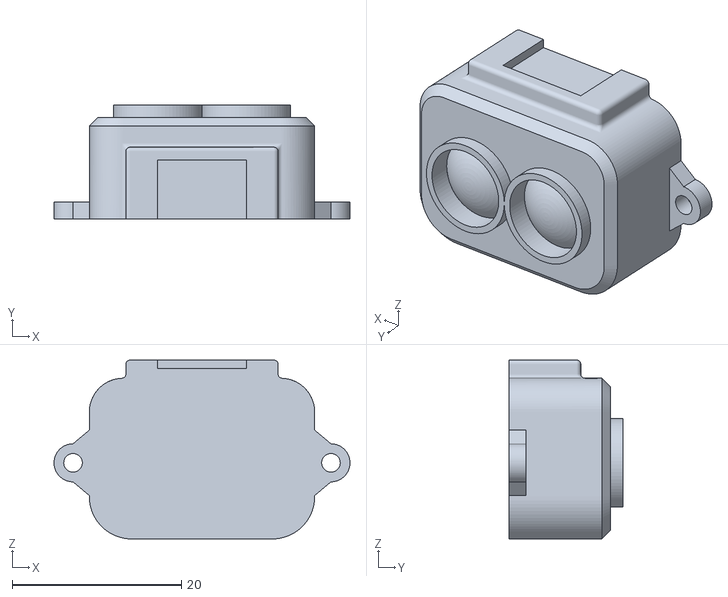
[picture p43: CAD file, 2025-06-06]
Control/Rasberry_pi/src/robot/meshes/LUNA.stl
35.0 x 13.5 x 21.1
