georg22tech/CLInGER/CAD_and_verification/Micro Servo V2.step

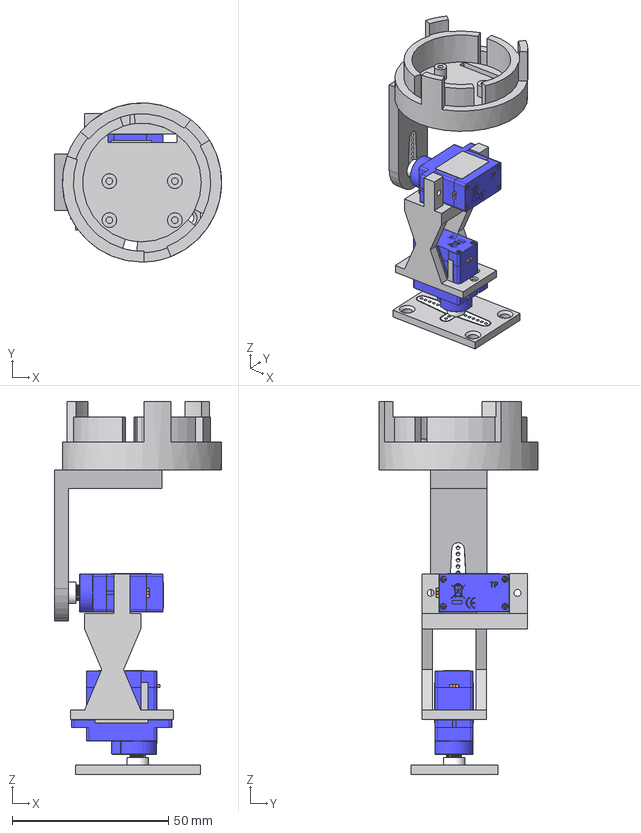
[picture p44: CAD file, 2025-06-06]
CAD_and_verification/Micro Servo V2.step
53.6 x 51.0 x 119.5 mm
SG90 - Micro Servo 9g - Tower Pro.4_Pe‡a (1)
SG90 - Micro Servo 9g - Tower Pro.5_BS EN ISO 7045 - M2 x 8 - Z - 8S (1) x 2
SG90 - Micro Servo 9g - Tower Pro.2_Pe‡a (1)
SG90 - Micro Servo 9g - Tower Pro.3_Pe‡a (1)
SG90 - Micro Servo 9g - Tower Pro.6_BS EN ISO 7045 - M2 x 4 - Z - 4S (1)
SG90 - Micro Servo 9g - Tower Pro.1_Pe‡a (1)
SG90 - Micro Servo 9g - Tower Pro.2.SLDPRT
SG90 - Micro Servo 9g - Tower Pro.4_Pe‡a
SG90 - Micro Servo 9g - Tower Pro.5_BS EN ISO 7045 - M2 x 8 - Z - 8S x 2
SG90 - Micro Servo 9g - Tower Pro.2_Pe‡a
SG90 - Micro Servo 9g - Tower Pro.3_Pe‡a
SG90 - Micro Servo 9g - Tower Pro.6_BS EN ISO 7045 - M2 x 4 - Z - 4S
SG90 - Micro Servo 9g - Tower Pro.1_Pe‡a
Bracket
