georg22tech/CLInGER/Control/Rasberry_pi/src/robot/meshes/top_frame.stl

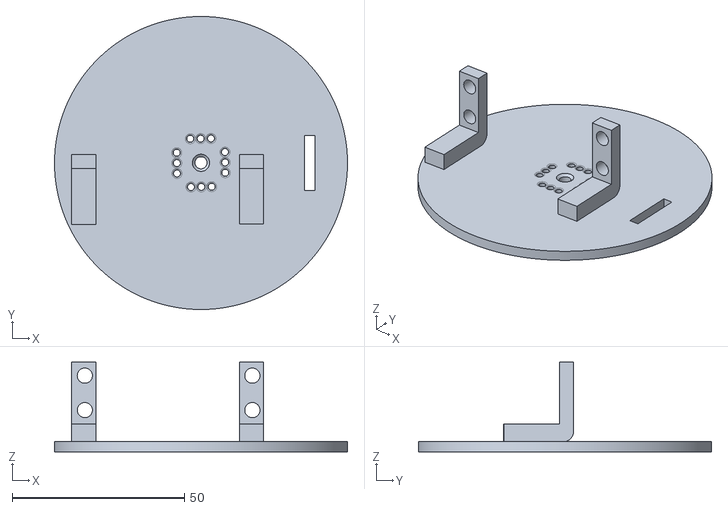
[picture p45: CAD file, 2025-06-06]
Control/Rasberry_pi/src/robot/meshes/top_frame.stl
85.0 x 85.0 x 26.0
