georg22tech/CLInGER/CAD_and_verification/servoattach.SLDPRT

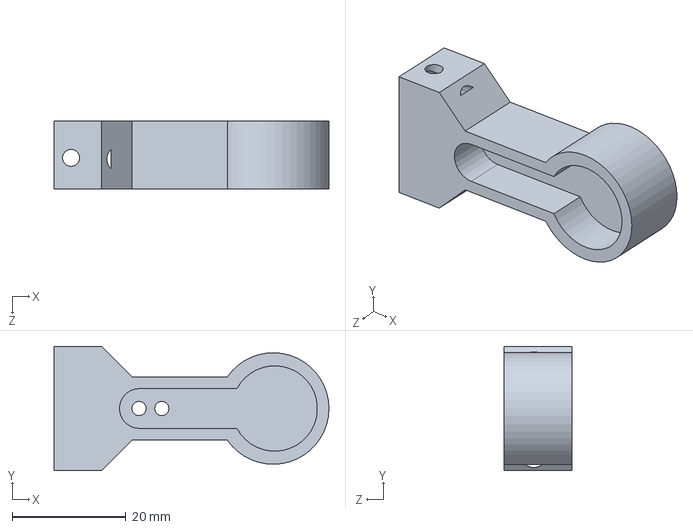
[picture p46: CAD file, 2025-06-06]
CAD_and_verification/servoattach.SLDPRT
48.3 x 21.8 x 12.0 mm
