georg22tech/CLInGER/Control/Rasberry_pi/src/robot/meshes/VL53l1X.stl

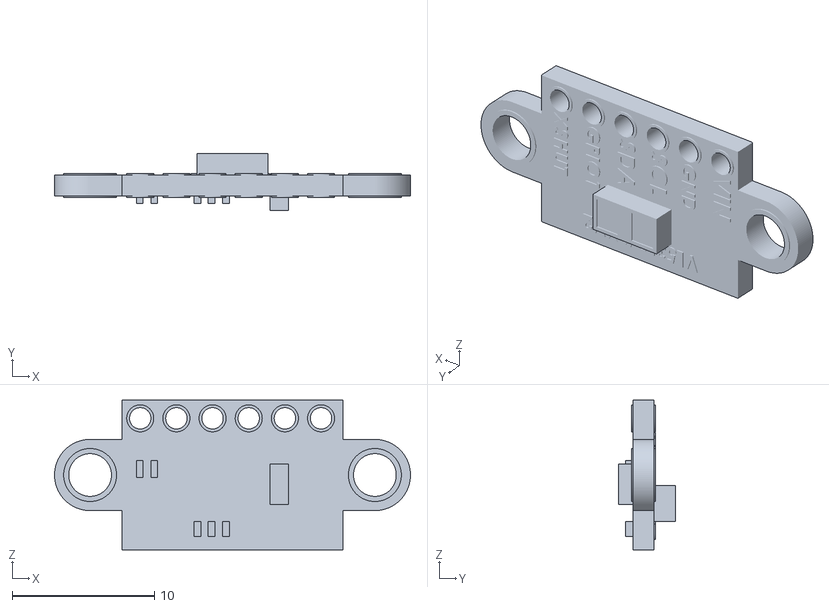
[picture p47: CAD file, 2025-06-06]
Control/Rasberry_pi/src/robot/meshes/VL53l1X.stl
25.0 x 4.00 x 10.5
