georg22tech/CLInGER/CAD_and_verification/oct_solidworks_designs/RacknPinion.SLDASM

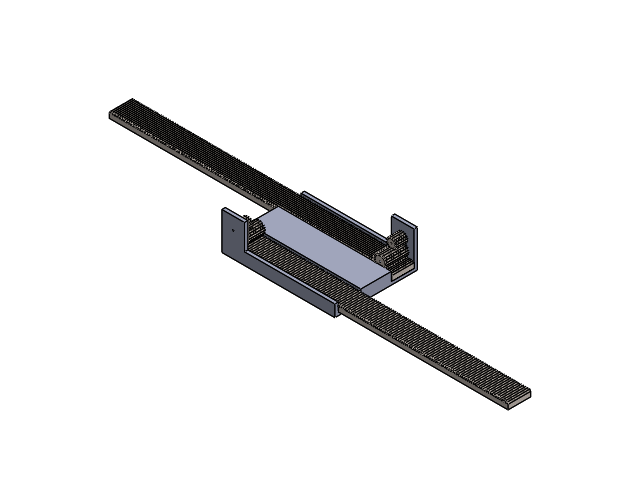
[picture p48: CAD file, 2025-06-06]
CAD_and_verification/oct_solidworks_designs/RacknPinion.SLDASM
frame
ISO - Spur gear 0.5M 20T 20PA 20FW ---S20A75H50L0.8N x 2
ISO - Rack-spur - rectangular 0.6M 20PA 20FW 5PH 250L---SAll
ISO - Rack-spur - rectangular 0.5M 20PA 20FW 5PH 250L---SAll
ISO - Spur gear 0.5M 16T 20PA 10FW ---S16A75H50L0.8N x 2
