georg22tech/CLInGER/CAD_and_verification/analysis_code/final_continuum_1.csv

x | y | xFulc | yFulc
314 | 333 | 270 | 704
312 | 334 | 270 | 704
312 | 336 | 270 | 704
312 | 334 | 270 | 704
312 | 335 | 270 | 704
312 | 334 | 270 | 705
312 | 335 | 270 | 704
313 | 336 | 270 | 704
312 | 335 | 270 | 704
313 | 336 | 270 | 704
313 | 336 | 270 | 704
312 | 335 | 270 | 705
312 | 336 | 269 | 704
312 | 335 | 269 | 704
312 | 336 | 270 | 705
312 | 335 | 270 | 705
312 | 335 | 270 | 705
312 | 336 | 270 | 705
312 | 336 | 271 | 705
311 | 336 | 270 | 705
312 | 336 | 271 | 705
312 | 334 | 270 | 705
312 | 336 | 270 | 705
312 | 335 | 270 | 705
312 | 335 | 271 | 705
312 | 336 | 271 | 705
312 | 336 | 270 | 705
312 | 335 | 270 | 705
312 | 336 | 270 | 705
312 | 335 | 270 | 705
312 | 336 | 270 | 705
312 | 335 | 270 | 705
312 | 335 | 270 | 705
312 | 336 | 270 | 705
312 | 336 | 270 | 705
312 | 336 | 270 | 705
312 | 336 | 270 | 705
312 | 336 | 270 | 705
312 | 336 | 270 | 705
312 | 336 | 270 | 705
312 | 336 | 270 | 705
312 | 336 | 270 | 705
312 | 336 | 270 | 705
312 | 335 | 270 | 705
312 | 336 | 270 | 705
312 | 336 | 270 | 705
312 | 336 | 271 | 705
312 | 336 | 270 | 705
312 | 335 | 270 | 705
312 | 336 | 271 | 705
312 | 336 | 271 | 705
312 | 336 | 271 | 705
312 | 336 | 271 | 705
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
