georg22tech/CLInGER/CAD_and_verification/analysis_code/final_continuum_2.csv

x | y | xFulc | yFulc
332 | 288 | 281 | 729
331 | 288 | 281 | 729
331 | 288 | 281 | 729
331 | 289 | 281 | 729
333 | 288 | 281 | 729
333 | 288 | 281 | 729
331 | 290 | 281 | 729
332 | 288 | 281 | 729
331 | 290 | 281 | 729
331 | 290 | 281 | 729
331 | 290 | 281 | 729
331 | 290 | 281 | 729
331 | 290 | 281 | 729
332 | 290 | 280 | 729
332 | 290 | 281 | 729
332 | 290 | 281 | 729
330 | 290 | 280 | 729
332 | 290 | 281 | 729
330 | 290 | 280 | 729
330 | 291 | 281 | 729
330 | 291 | 281 | 729
331 | 290 | 281 | 729
329 | 290 | 281 | 729
330 | 291 | 281 | 729
330 | 291 | 281 | 729
329 | 291 | 281 | 728
330 | 291 | 281 | 729
330 | 291 | 281 | 729
330 | 291 | 281 | 729
330 | 291 | 281 | 729
330 | 291 | 281 | 729
330 | 291 | 281 | 729
330 | 291 | 281 | 729
330 | 291 | 281 | 729
330 | 291 | 281 | 729
329 | 291 | 281 | 729
330 | 291 | 281 | 729
329 | 291 | 281 | 729
329 | 291 | 281 | 729
329 | 291 | 280 | 729
329 | 291 | 280 | 729
329 | 291 | 280 | 729
329 | 291 | 280 | 729
329 | 291 | 280 | 729
329 | 291 | 280 | 729
329 | 291 | 280 | 729
329 | 291 | 280 | 729
328 | 291 | 280 | 729
328 | 291 | 280 | 729
328 | 291 | 280 | 729
328 | 291 | 280 | 729
328 | 291 | 280 | 729
328 | 291 | 280 | 728
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
