georg22tech/CLInGER/Camera System/HRI/yolo_v11_model/cracks_v4/train/results.csv

epoch | time | train/box_loss | train/cls_loss | train/dfl_loss | metrics/precision(B) | metrics/recall(B) | metrics/mAP50(B) | metrics/mAP50-95(B) | val/box_loss | val/cls_loss | val/dfl_loss | lr/pg0 | lr/pg1 | lr/pg2
1 | 7.51285 | 1.68019 | 3.07312 | 1.73781 | 0.00483 | 0.82857 | 0.239 | 0.13315 | 1.57756 | 3.09406 | 1.73171 | 0.0002 | 0.0002 | 0.0002
2 | 11.7365 | 1.4701 | 2.67652 | 1.58993 | 0.00517 | 0.88571 | 0.21458 | 0.09119 | 1.51254 | 3.0448 | 1.75349 | 0.000415842 | 0.000415842 | 0.000415842
3 | 16.7001 | 1.53065 | 2.31809 | 1.5659 | 0.00663 | 0.74286 | 0.21107 | 0.08973 | 1.59059 | 3.02696 | 1.86015 | 0.000627328 | 0.000627328 | 0.000627328
4 | 20.5367 | 1.46862 | 2.1046 | 1.48651 | 0.73906 | 0.14286 | 0.25594 | 0.10723 | 1.75797 | 2.98581 | 2.24996 | 0.000834458 | 0.000834458 | 0.000834458
5 | 24.3989 | 1.52826 | 2.07061 | 1.53938 | 0.00303 | 0.51429 | 0.03596 | 0.00881 | 2.99654 | 3.99396 | 3.05811 | 0.00103723 | 0.00103723 | 0.00103723
6 | 29.473 | 1.56465 | 2.07598 | 1.53336 | 0.15891 | 0.14286 | 0.13937 | 0.05865 | 2.03466 | 3.14912 | 2.2185 | 0.00123565 | 0.00123565 | 0.00123565
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
