georg22tech/CLInGER/Camera System/HRI/FD_images/amentum_visit_test/1.1/image_2025-03-18_11-51-19.jpg

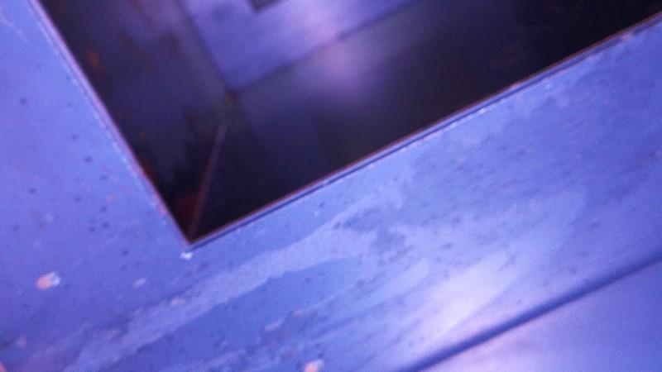
Camera System/HRI/FD_images/amentum_visit_test/1.1/image_2025-03-18_11-51-19.jpg
