georg22tech/CLInGER/Camera System/HRI/FD_images/amentum_visit_test/1.3/image_2025-03-18_12-00-02.jpg

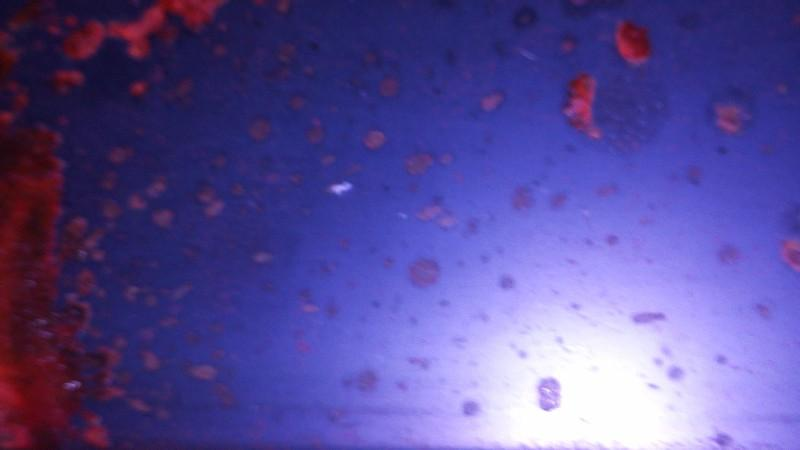
Camera System/HRI/FD_images/amentum_visit_test/1.3/image_2025-03-18_12-00-02.jpg
