georg22tech/CLInGER/Camera System/HRI/FD_images/amentum_visit_test/1.4/amentum_test_rear.jpg

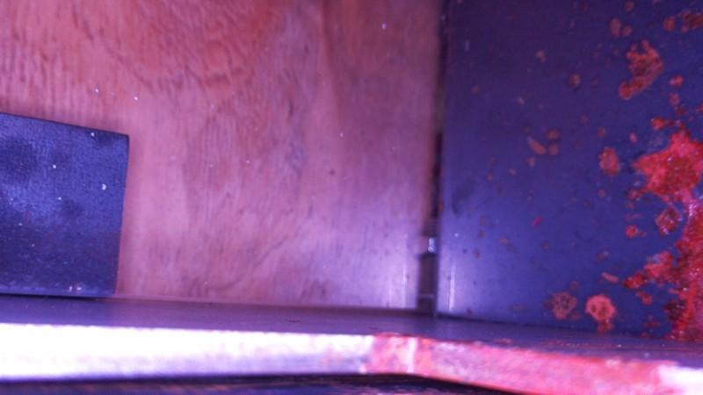
Camera System/HRI/FD_images/amentum_visit_test/1.4/amentum_test_rear.jpg
