georg22tech/CLInGER/Camera System/HRI/FD_images/amentum_visit_test/1.4/image_2025-03-18_12-06-08.jpg

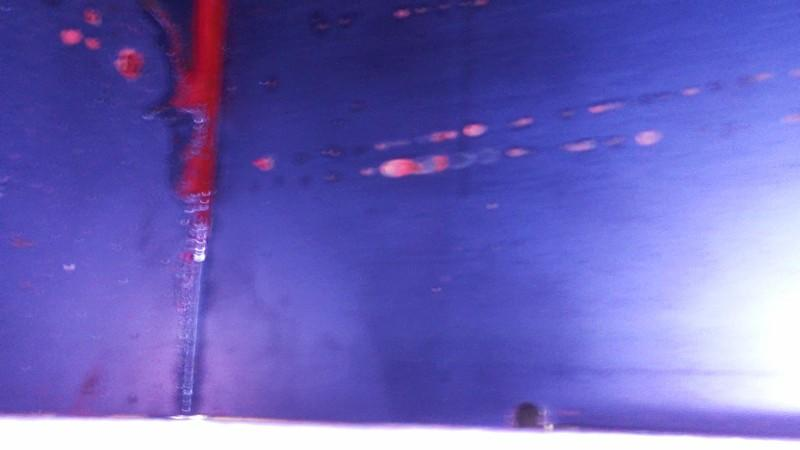
Camera System/HRI/FD_images/amentum_visit_test/1.4/image_2025-03-18_12-06-08.jpg
