georg22tech/CLInGER/Camera System/HRI/FD_images/amentum_visit_test/3.2/image_2025-03-18_12-13-21.jpg

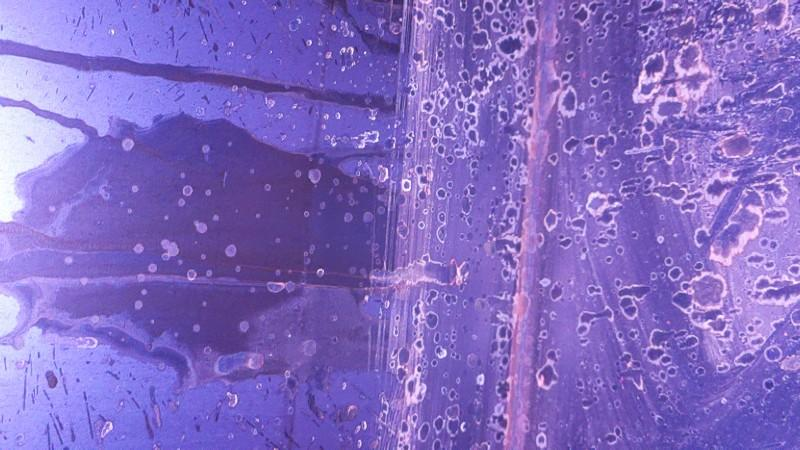
Camera System/HRI/FD_images/amentum_visit_test/3.2/image_2025-03-18_12-13-21.jpg
