georg22tech/CLInGER/Camera System/HRI/FD_images/amentum_visit_test/4.1/amentum_light_25.jpg

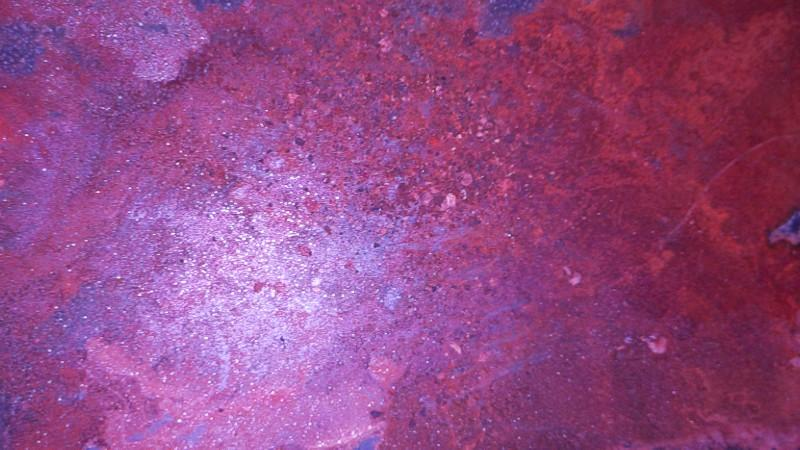
Camera System/HRI/FD_images/amentum_visit_test/4.1/amentum_light_25.jpg
