georg22tech/CLInGER/Camera System/HRI/FD_images/amentum_visit_test/4.1/image_2025-03-18_12-20-38.jpg

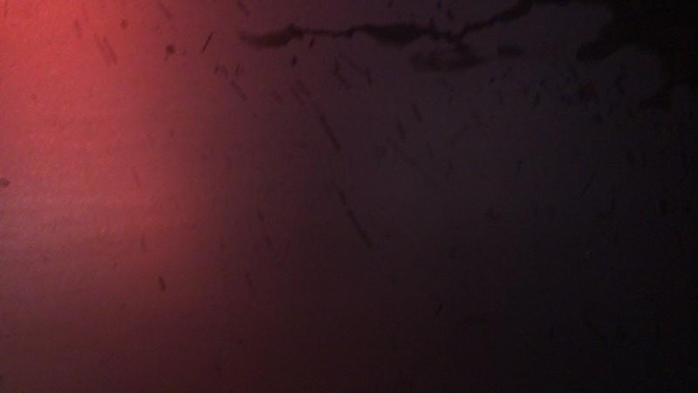
Camera System/HRI/FD_images/amentum_visit_test/4.1/image_2025-03-18_12-20-38.jpg
