georg22tech/CLInGER/Camera System/HRI/FD_images/amentum_visit_test/uni_tests/1.1/image_2025-03-11_18-48-57.jpg

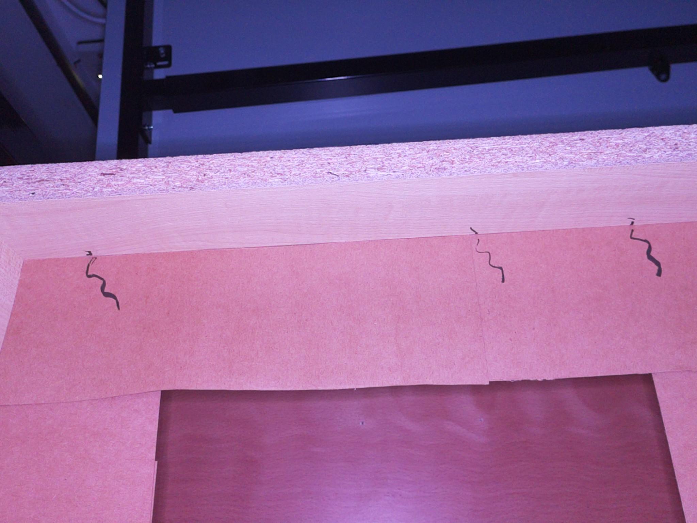
Camera System/HRI/FD_images/amentum_visit_test/uni_tests/1.1/image_2025-03-11_18-48-57.jpg
