georg22tech/CLInGER/Camera System/HRI/FD_images/amentum_visit_test/uni_tests/1.2/image_2025-03-11_18-52-04.jpg

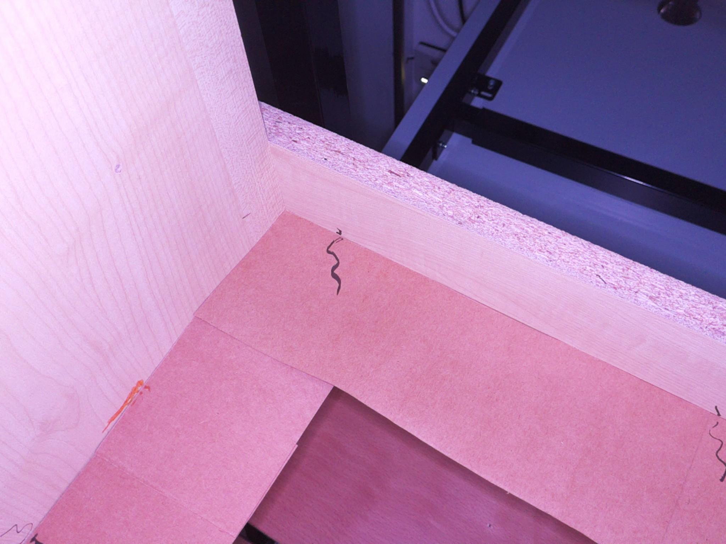
Camera System/HRI/FD_images/amentum_visit_test/uni_tests/1.2/image_2025-03-11_18-52-04.jpg
