georg22tech/CLInGER/Camera System/HRI/FD_images/amentum_visit_test/uni_tests/1.3/image_2025-03-12_15-59-02.jpg

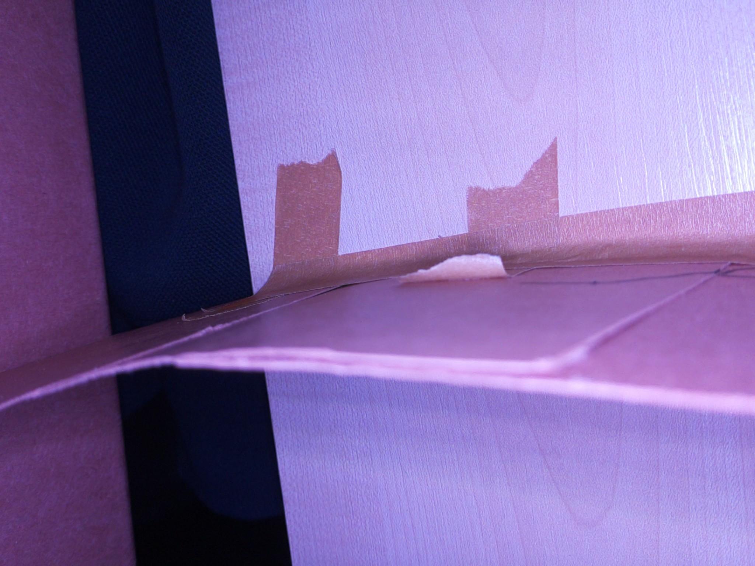
Camera System/HRI/FD_images/amentum_visit_test/uni_tests/1.3/image_2025-03-12_15-59-02.jpg
