georg22tech/CLInGER/Camera System/HRI/FD_images/amentum_visit_test/uni_tests/1.4/image_2025-03-12_16-08-22.jpg

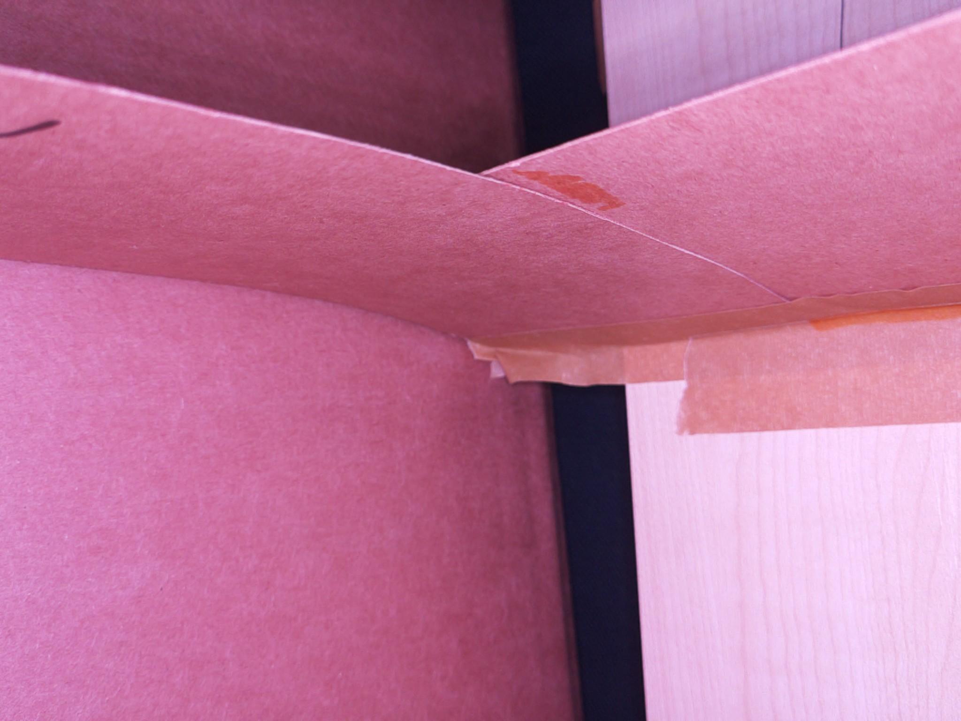
Camera System/HRI/FD_images/amentum_visit_test/uni_tests/1.4/image_2025-03-12_16-08-22.jpg
