georg22tech/CLInGER/Camera System/HRI/FD_images/amentum_visit_test/uni_tests/2.1/image_2025-03-12_16-38-03.jpg

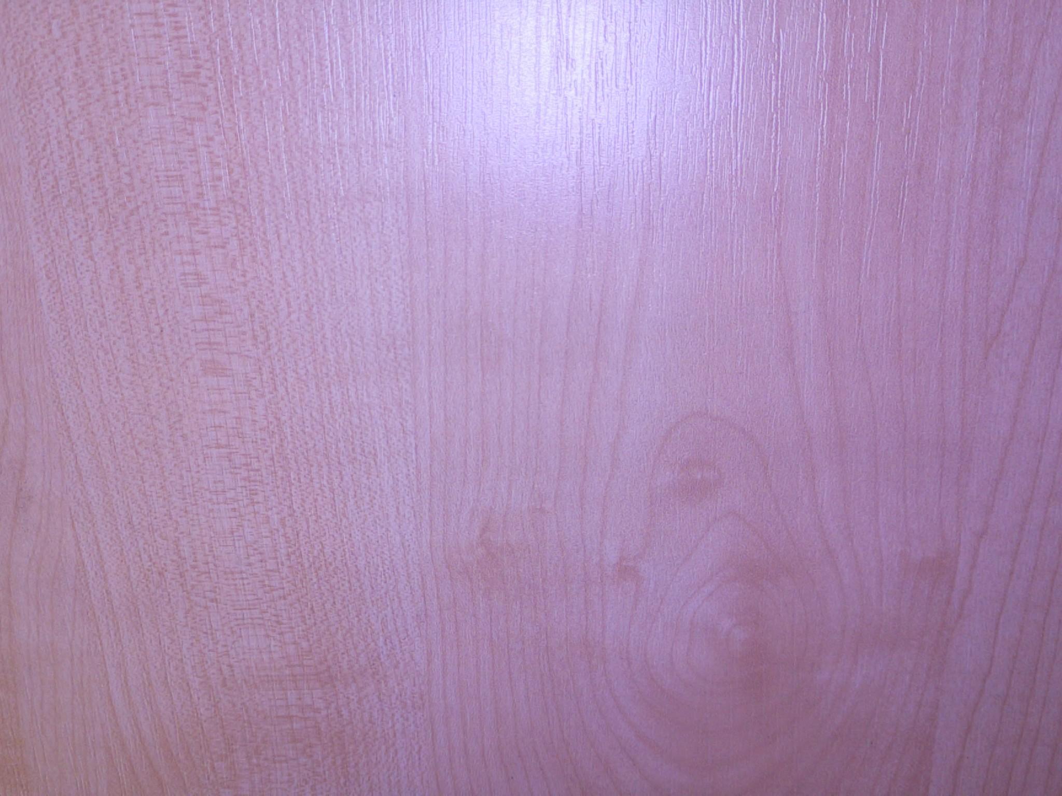
Camera System/HRI/FD_images/amentum_visit_test/uni_tests/2.1/image_2025-03-12_16-38-03.jpg
