georg22tech/CLInGER/Camera System/HRI/FD_images/test_images/image_2025-03-28_08-51-15.jpg

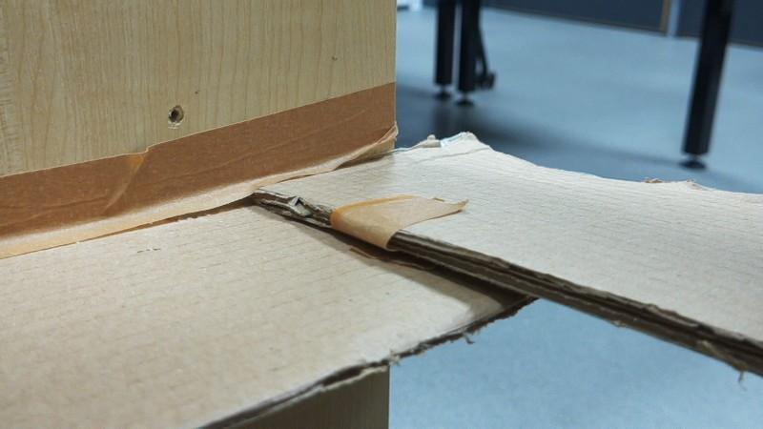
Camera System/HRI/FD_images/test_images/image_2025-03-28_08-51-15.jpg
