georg22tech/CLInGER/Appendices/Appendix A.12 - Electronic Design Files/Schematics and Layout for Top PCB.pdf

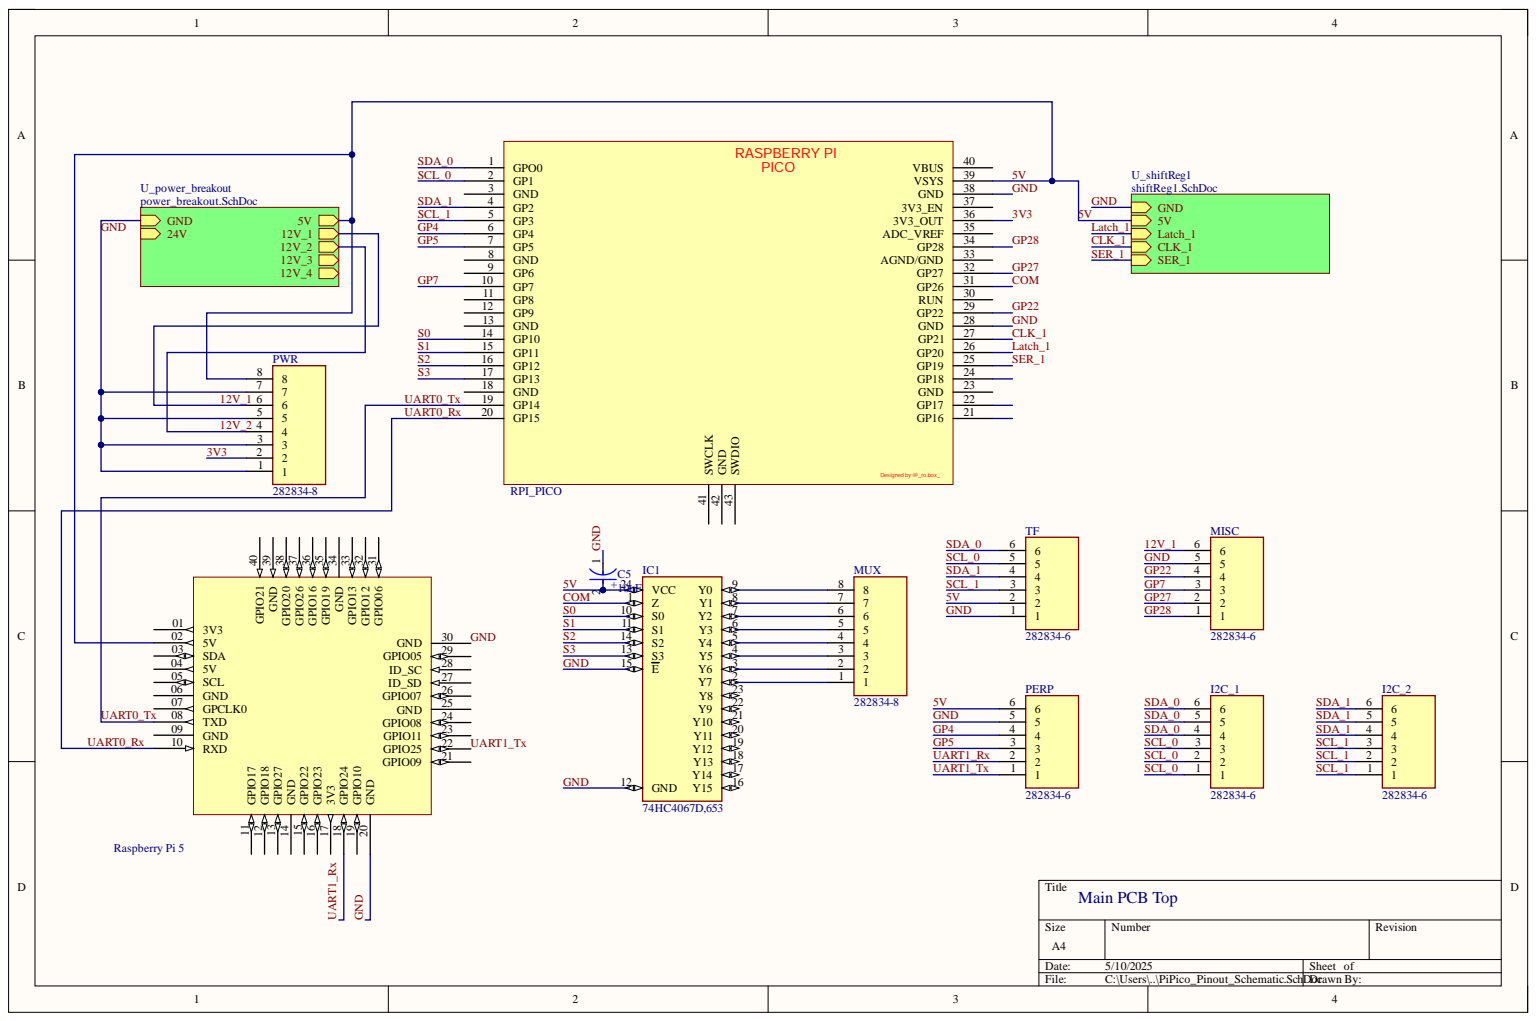
[picture p152: page 1]

1 | SCL _ 0 2
1 | SCL _ 0 1

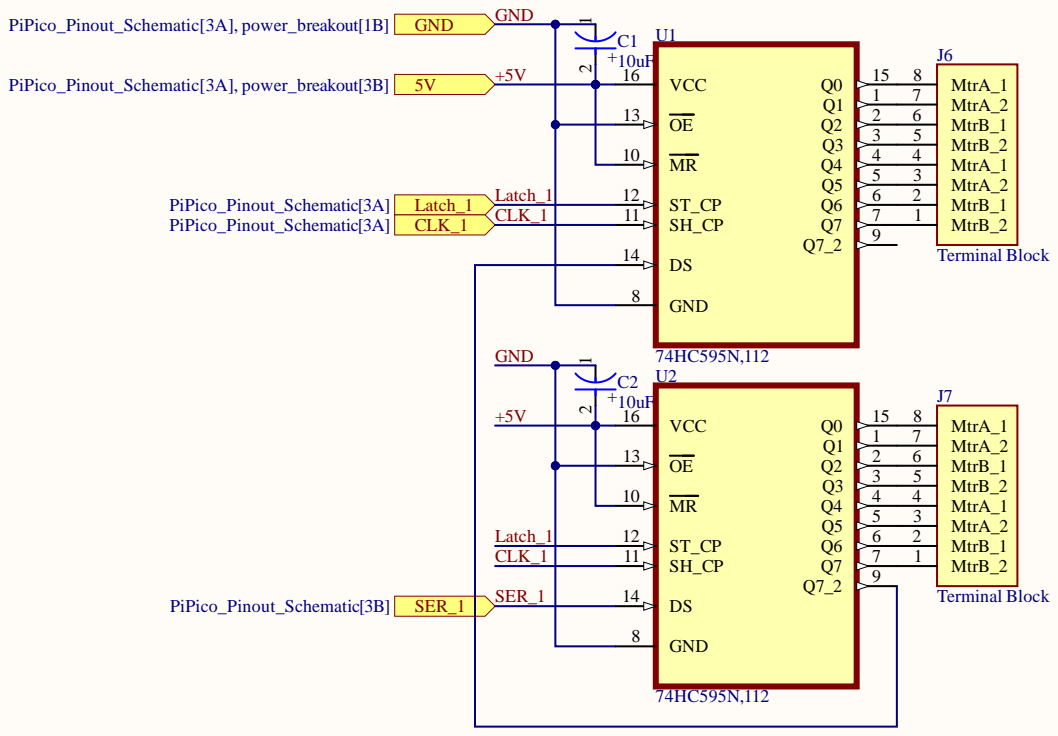
[picture p153: page 2]

SER_1 | DS 14

GND 8

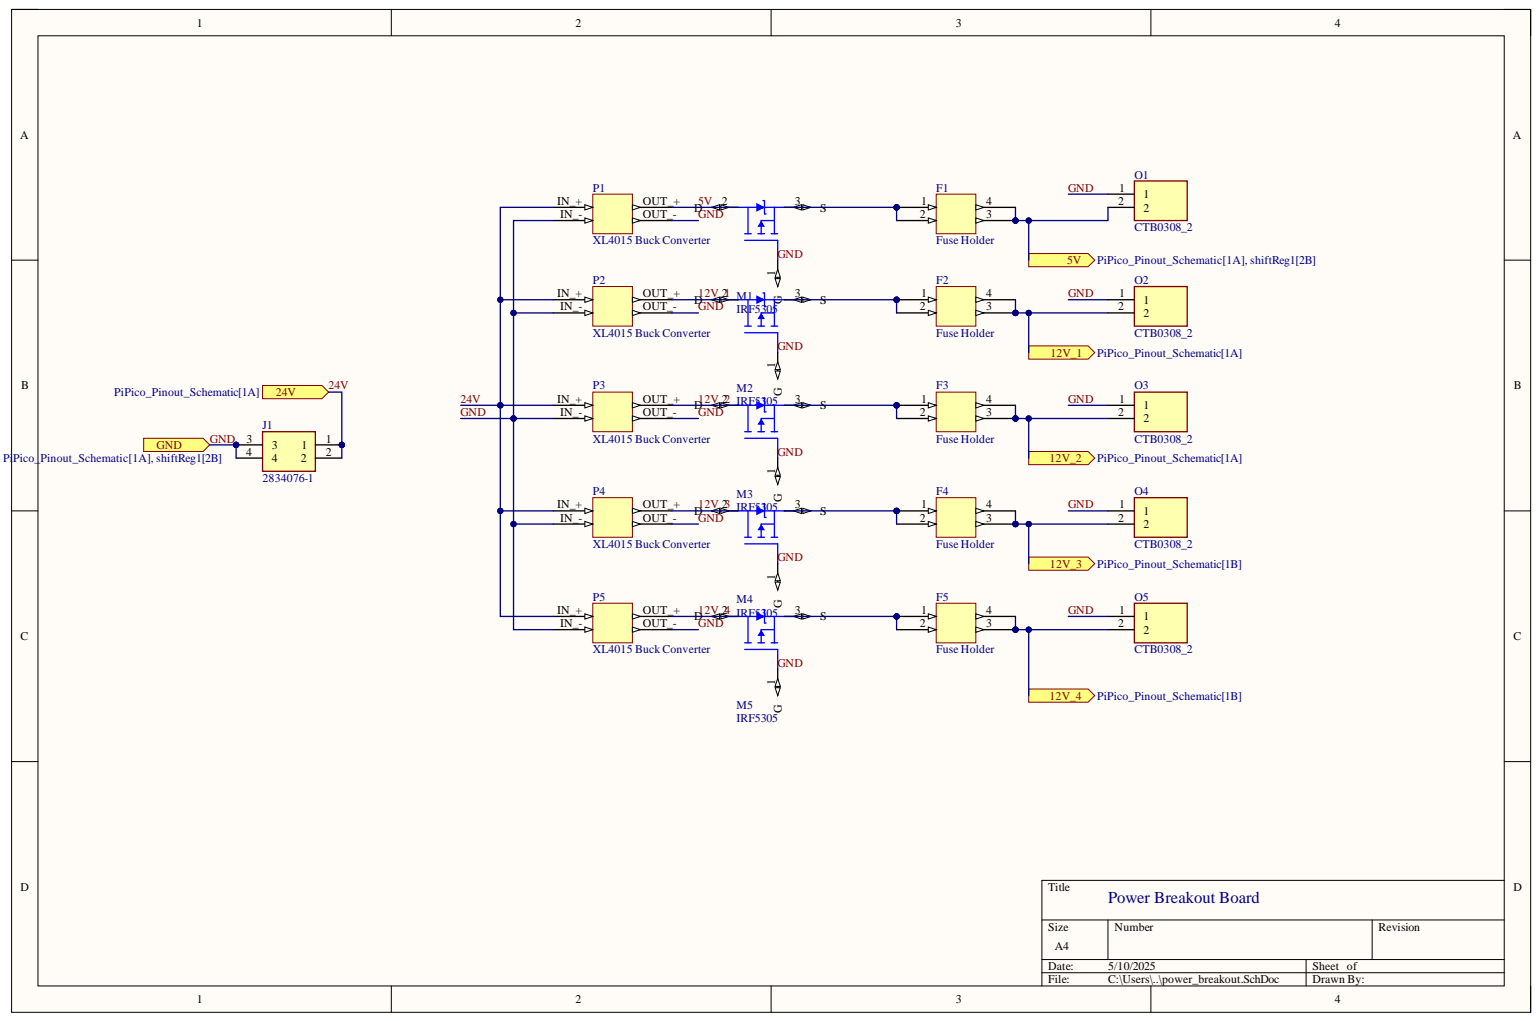
[picture p154: page 3]

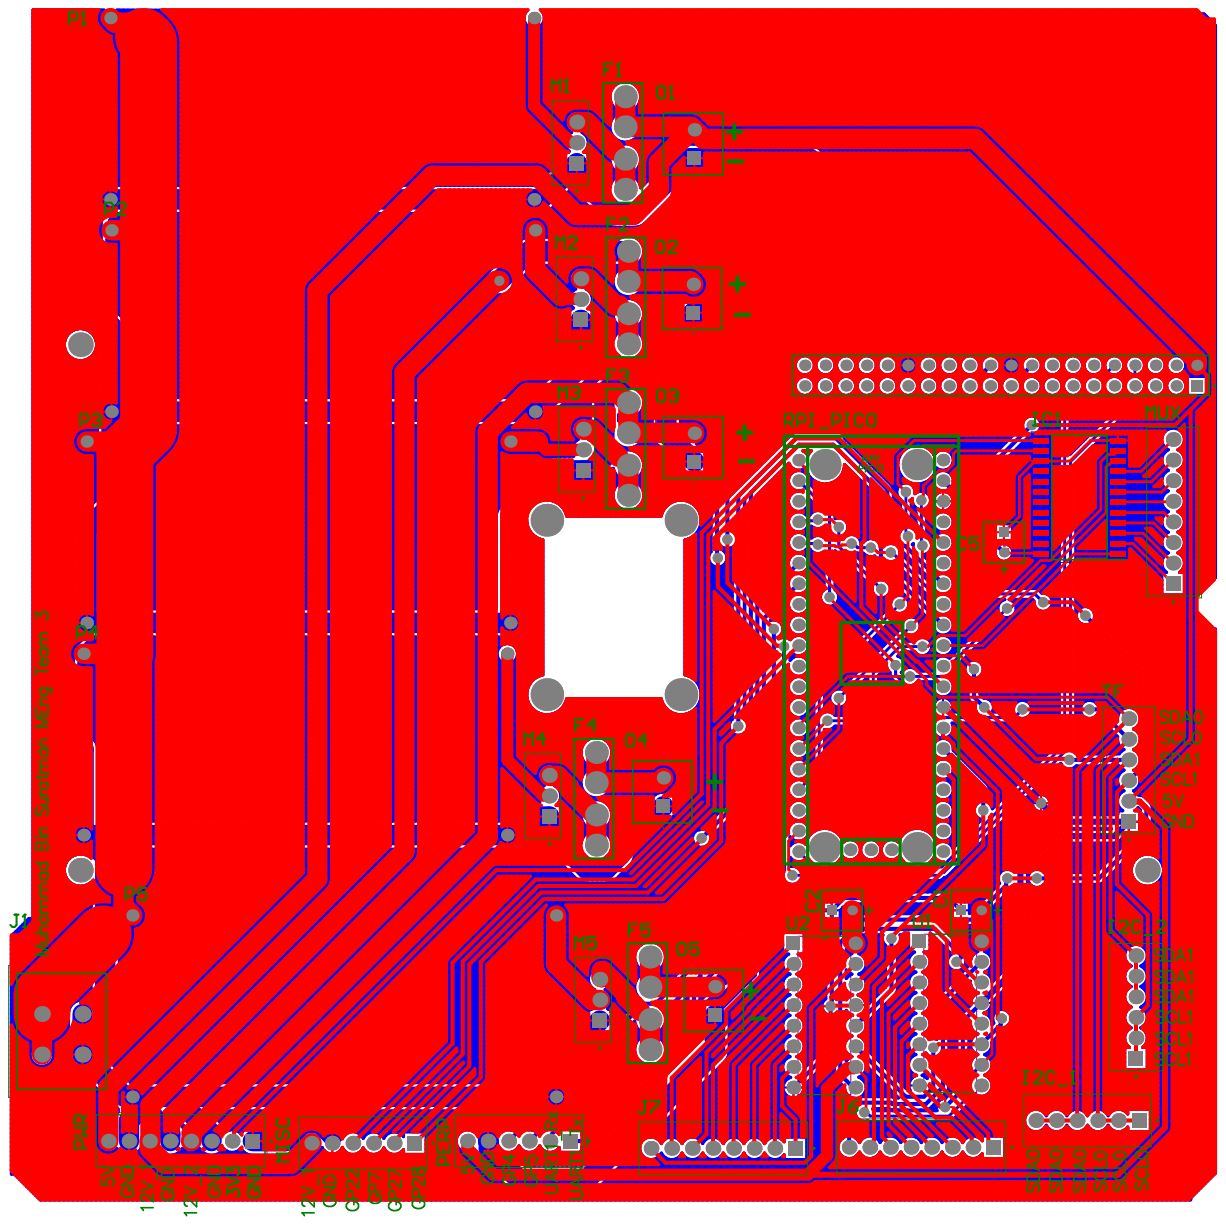
[picture p155: page 4]
