georg22tech/CLInGER/Appendices/Appendix A.5 - Gantt Charts and Task Tracking/Appendix 2 - Gantt Chart.pdf

MEng Project Team 3 | 21 Nov 2024

# Gantt Chart

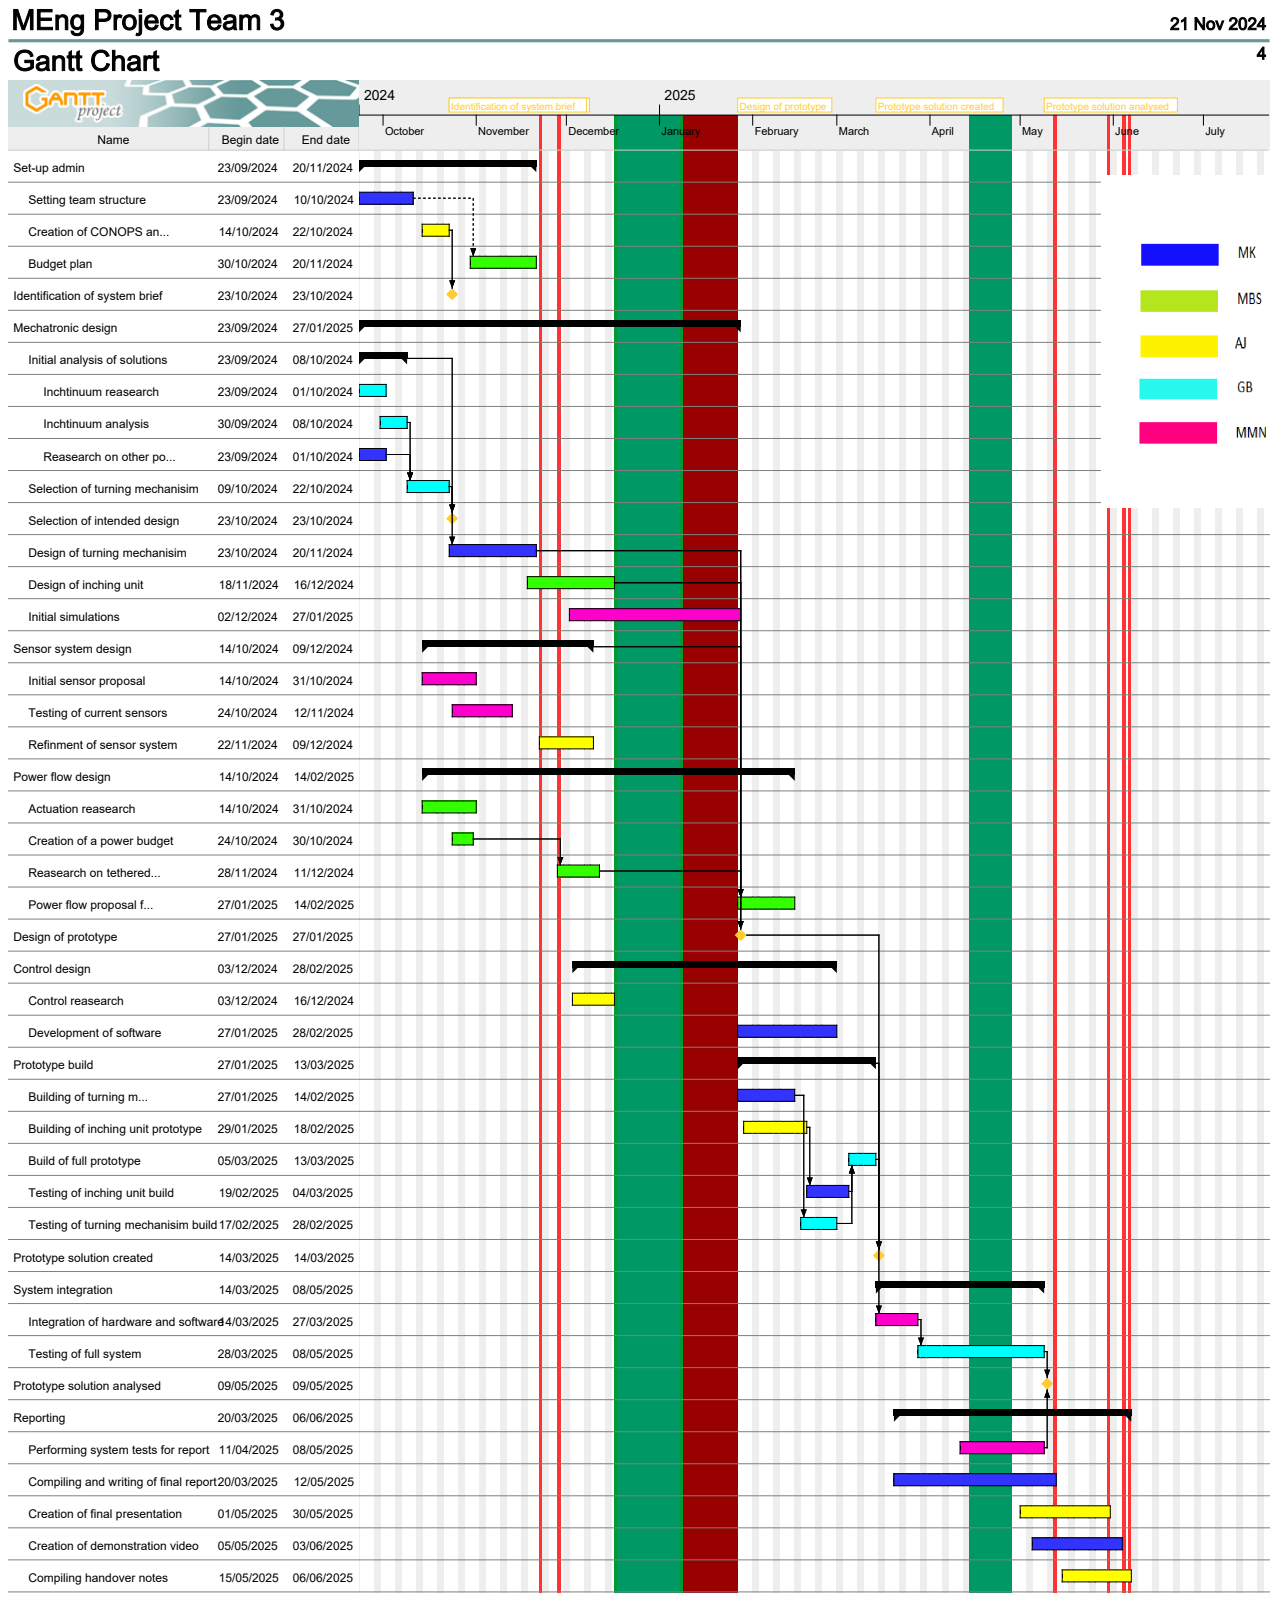
[picture p156: page 1]
Name; Begin date; End date; Set-up admin; Setting team structure; Creation of CONOPS an...; Budget plan; Identification of system brief; Mechatronic design; Initial analysis of solutions; Inchtinuum reasearch; Inchtinuum analysis; Reasearch on other po...; Selection of turning mechanisim; Selection of intended design; Design of turning mechanisim; Design of inching unit; Initial simulations; Sensor system design; Initial sensor proposal; Testing of current sensors; Refinment of sensor system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
