georg22tech/CLInGER/(list of files, drawings)

Other design files:
Appendices/Appendix A.12 - Electronic Design Files/PiPico_Pinout.SchDoc
Appendices/Appendix A.12 - Electronic Design Files/power_breakout.SchDoc
Appendices/Appendix A.12 - Electronic Design Files/shiftReg1.SchDoc
