georg22tech/CLInGER/Control/Pi_pico/control_code/pins.py

##### INPUTS #####
#HRI input pins
JOYSTICK_1 = 0
JOYSTICK_2 = 0
BUTTON_1 = 0
BUTTON_2 = 0
E_STOP = 0
#Sensor input pins
IMU_0_0 = 0
IMU_0_1 = 0
IMU_1_0 = 0
IMU_1_1 = 0
TOF_1 = 0
TOF_2 = 0
##### OUTPUTS #####
#inching motor 1
INCH_1_1 = 0
INCH_1_2 = 0
ENA_INCH_1 = 0
#inching motor 2
INCH_2_1 = 0
INCH_2_2 = 0
ENA_INCH_2 = 0
#inching motor 3
INCH_3_1 = 0
INCH_3_2 = 0
ENA_INCH_3 = 0
#inching motor 4
INCH_4_1 = 0
INCH_4_2 = 0
ENA_INCH_4 = 0
#inching motor 5
INCH_5_1 = 0
INCH_5_2 = 0
ENA_INCH_5 = 0
#inching motor 6
INCH_6_1 = 0
INCH_6_2 = 0
ENA_INCH_6 = 0
#inching motor 7
INCH_7_1 = 0
INCH_7_2 = 0
ENA_INCH_7 = 0
#inching motor 8
INCH_8_1 = 0
INCH_8_2 = 0
ENA_INCH_8 = 0
#continuum motor 1
CONT_1_1 = 0
CONT_1_2 = 0
ENA_CONT_1 = 0
#continuum motor 2
CONT_2_1 = 0
CONT_2_2 = 0
ENA_CONT_2 = 0
